sametyakut/EE463-TERM-PROJECT/README.md

# EE463-TERM-PROJECT
This repository is created for DC Motor Drive Project by **Son Motor Bükücüler**.

Team: [Berna ÇORAK](https://github.com/burniebarren), [Musa ULUSOY](https://github.com/Musa1088) and [me](https://github.com/sametyakut).
