sametyakut/EE463-TERM-PROJECT/Reports/FinalReport.docx

EE463 STATIC POWER

CONVERSION-I

TERM PROJECT

FINAL REPORT

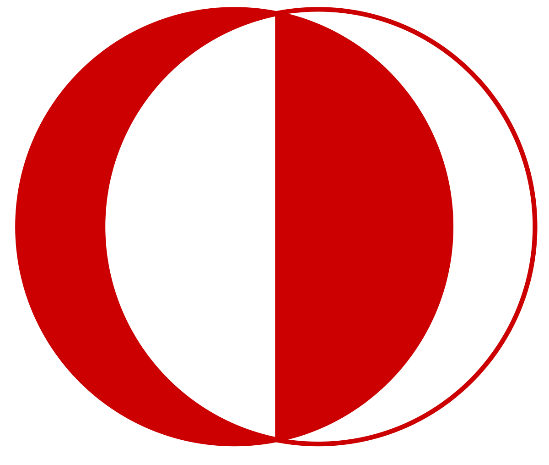
[picture p3: figure]
Orta Doğu Teknik Üniversitesi - Vikipedi

Date: 07.02.2022

Musa Ulusoy 2305555

Muhammet Samet Yakut 2305647

Berna Çorak 2304392

# I. INTRODUCTION

In our term project we were required to build a motor driver circuitry which will run a DC motor via AC grid. In this report, the topology we have chosen and the reason behind it is discussed. Necessary analytical calculations are given. Simulation of the circuitry is talked upon, and component selection is presented. Next, thermal calculations and the implementation are provided. Finally, demonstration results are talked upon, both rated operation and kettle test.

# II. PROJECT DEFINITION

In this project, as mentioned in introduction, we are asked to build a motor driver supplied from the grid -either single or three phase- that can drive an industrial shunt motor with a rated 1500 rpm speed, 220 V and 23.4 A. Field excitation is given by an external DC source. There are several bonus requirements, among which we have chosen Tea Bonus, Analog Controller Bonus and Industrial Design Bonus to implement. For Tea Bonus, the motor that is run with our driver is coupled to a generator which is used to supply voltage to a kettle drawing around 1.5 kW. Our design should be able to withstand until the water is boiled. For Analog Controller Bonus, as the name suggests, the driver needs to be implemented with an analog controller rather than digital. And for Industrial Bonus, the driver should be encased within a box with all ports labeled.

# III. TOPOLOGY SELECTION

For this project, basic topologies that we considered are as follows:

- Center-tap transformer: This topology turned out to be way expensive compared to others (~300 TL), therefore it is automatically eliminated. Besides this, in the small scale it has only one tap at the secondary, decreasing the flexibility of the output voltage, if used as a single component.
- Single phase full bridge diode rectifier with buck converter: This topology is comparably cheaper compared to others. However maximum output voltage that a single-phase diode rectifier can provide is 207 V, when variac is at 100%. That means for a maximum operational output of 180 V, duty cycle (DC) of the buck converter should be around 90%, which is not desired since as DC gets closer to the edges, its output becomes instable and non-reliable.
- Single phase thyristor rectifier: Similarly with the previous topology, maximum output this can provide is 207 V. For 180 V output, 30° of firing angle is required, which is reasonable. However, compared to the next topology especially, two gate driver circuitry is needed, complicating the matters. Even though pricewise being comparable with the three phase full bridge diode rectifier with buck converter, this topology is found to be more error-prone due to this multiple gate driver requirement and hence is not chosen.
- Three phase full bridge diode rectifier with buck converter: This topology is decided upon at the end, due to it being cheap and its ease of implementation. Since the motor acts like a capacitive load in addition with its series parasitic inductance, two components of the buck converter is not necessary, decreasing the cost even further and simplifying the circuitry. Only a gate driver is basically needed, which is doable.
- Three phase thyristor rectifier: Compared with the single phase case, cost and complexity is tripled, thus this topology is, too, eliminated.

# IV. SOLUTION

Figure 1. Schematic model of the selected topology

First of all, the LC filter at the output of the buck converter will not be used because the DC motor has a very large inductance that can filter the current in the square waveform. In other words, the DC machine will be driven with the square wave.

Secondly, transient current must be diminished to obtain a soft start operation. There are two ways: designing a controller (closed-loop operation) or designing a gate driver circuit such that the duty cycle starts from very low values and rises up to the maximum limit manually (open-loop operation). At first, a closed-loop PI controller is tried via TL494 IC; however, it is not ended with success. Therefore, due to lack of time, the open-loop operation is selected, and the following gate-driver circuit is designed.

Finally, the input voltage is desired according to the limited maximum duty cycle, which is 0.65. The duty cycle is limited in order to decrease the conduction loss, and the switching frequency is limited to 1 kHz to reduce the switching loss. So, the required input voltage for obtaining 180 V output voltage is calculated as

## Gate Driver Circuit

As previously mentioned, the open-loop operation with soft start is aimed. The PWM is generated via 555 timer. So, after brief research, the following gate driver circuit is designed, schematic of which is given in Figure 3. The numbers represent the ports of the timer in pin diagram. The pin diagram and appearance of the 555 timer is also presented below in Figure 2.

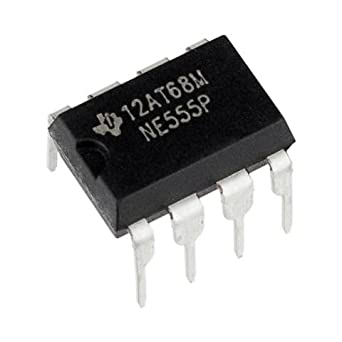
[picture p4: figure]
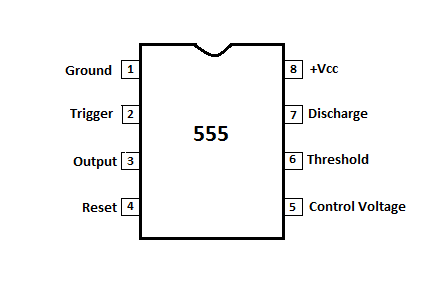
[picture p5: figure]

Figure 2. 555 timer photograph and pin diagram

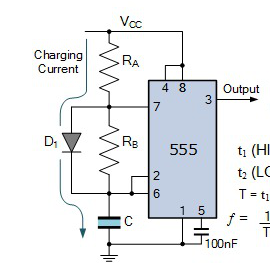
[picture p6: figure]

Figure 3. Gate driver circuitry

According to this topology, the duty cycle can be expressed as . Furthermore, the switching frequency is calculated as . Then, in order to achieve the desired duty cycle and switching frequency, resistor and capacitor parameters are tuned as , , and . RA will be composed of two series potentiometers in order to change the duty cycle. Specifically speaking, RA will be consisting of 100 kΩ and 10 kΩ resistors, which are series. The soft-start operation is achieved via 10 kΩ POT while the 100 kΩ POT is set as zero. After the start, duty cycle is adjusted via 100 kΩ POT.

After the 555 timer, the optocoupler is needed to isolate the gate driver circuit, i.e., prevent the gate driver circuit. For that purpose, the internal schematic of a typical optocoupler is presented to illustrate its working principle.

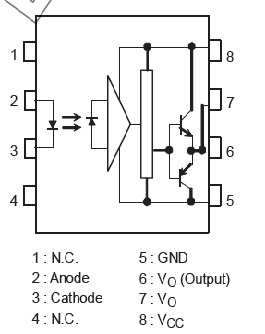
[picture p7: figure]

Figure 4. Schematic of optocoupler

The optocoupler utilizes the light to isolate one side from another, that’s what their name comes from. The picture above is the inside of the optocoupler. So, a 1 kΩ resistor will be placed to the pin 2 in order to limit the LED current in the input side of the optocoupler. Also, the PWM signal generated by the timer circuit is also connected to the second pin. Then, at the 6th or 7th pin, the same PWM signal will also be obtained. The 5th pin will be connected to the switch’s low voltage pin, which is the emitter.

Also, according to the datasheet of the switch (for reasoning of component selection please refer to the preceding simulation results and component selection sections), there must be at least a 10 Ω resistor placed in the gate of the IGBT. However, this value is for nearly perfect applications. Since it is not possible to design such a circuit, a 50 Ω resistor is used to increase the opening time of the switch, i.e., it is used to decrease the switching speed. There is also a 20 kΩ resistor for discharging the junction of the switch when it is turning of. Final version of the gate driver circuit including the IGBT is presented in Figure 5.

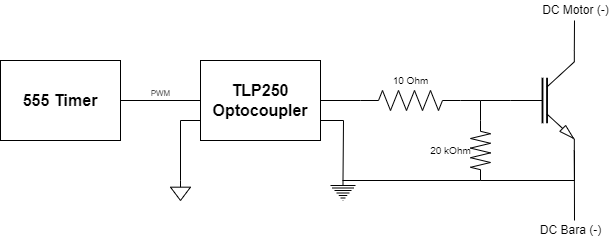
[picture p8: figure]

Figure 5. Schematic of the resultant gate driver

## Buck Converter

Buck converter is a basic step-down converter, and it will be utilized to drop the DC link voltage to the at most 180 V depending on the duty cycle. The basic buck converter topology is presented in Figure 6.

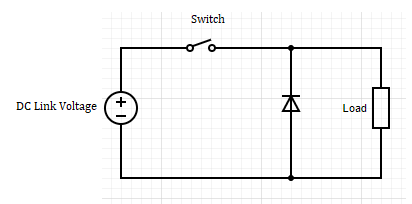
[picture p9: figure]

Figure 6. Schematic model of the basic buck converter

It can be easily seen that whenever switch is on, the output voltage is equal to DC link voltage, and whenever the diode is conducting, output voltage will be zero. Mathematically speaking

If the mean value of the output voltage is calculated, it can be seen that it is equal to 180 V at the maximum duty cycle which is the desired output voltage according to the project definition. In more detail,

In the preceding section, this solution procedure will be implemented in Simulink environment except the gate driver circuit because the components in gate driver circuit are not available in Simulink. So, gate driver topology will be implemented and simulated in LTSpice environment.

# V. SIMULATION RESULTS

The desired topology is simulated via Simulink environment. The Simulink model can be seen in Figure 7. According to the model, steady state switch current and voltage, diode current and voltage, and output voltage and current are given in Figures 8-10.

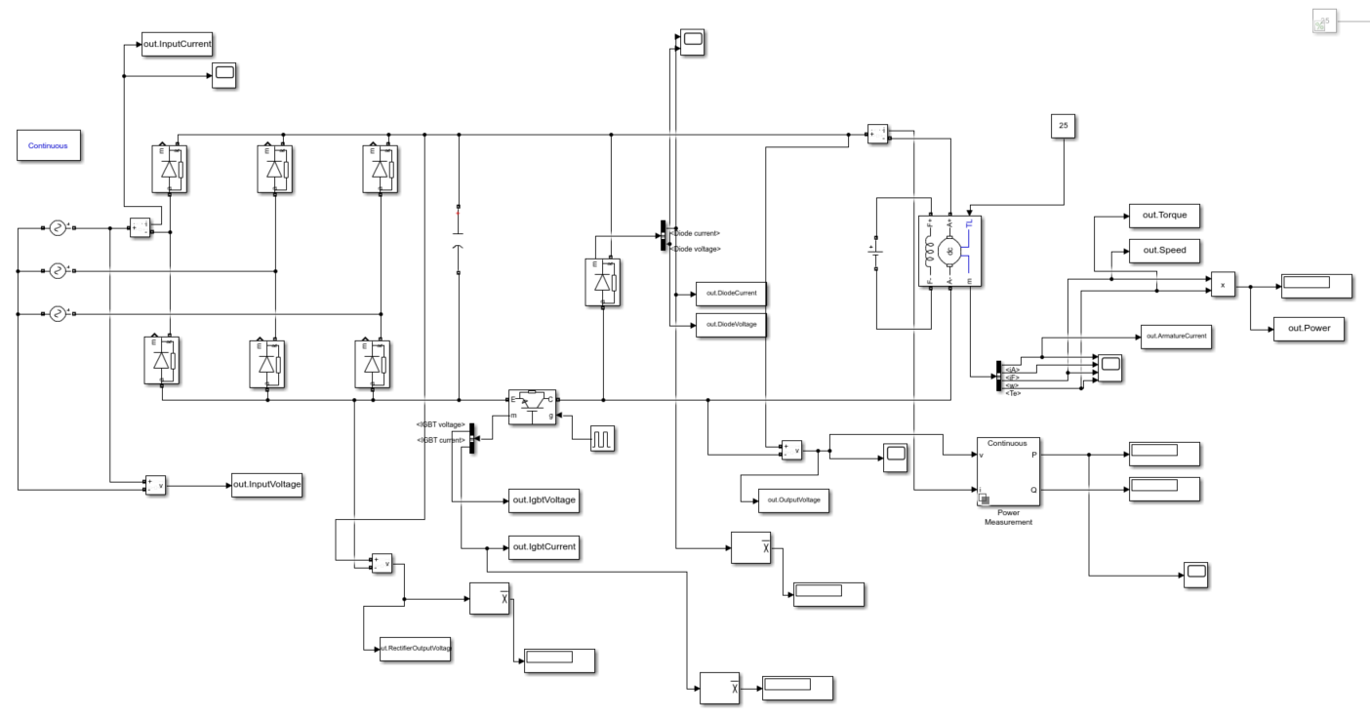
[picture p10: figure]

Figure 7. Simulink model

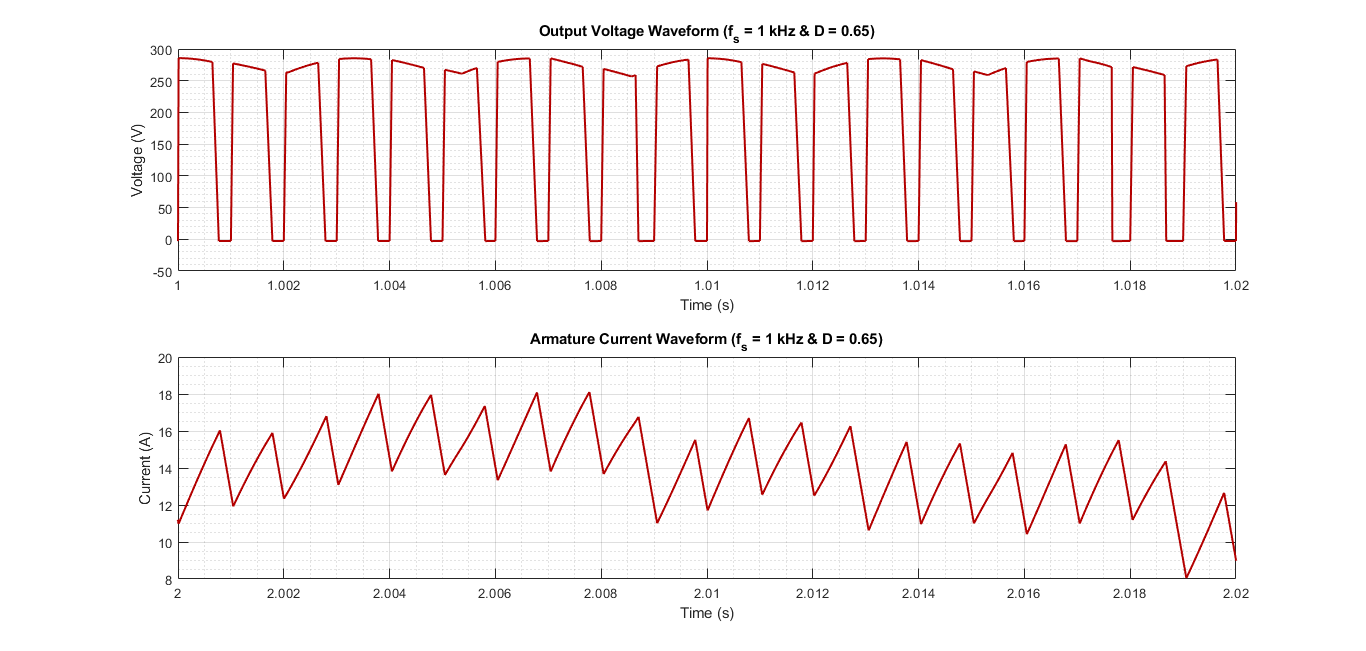
[picture p11: figure]

Figure 8. Output voltage and armature current waveforms

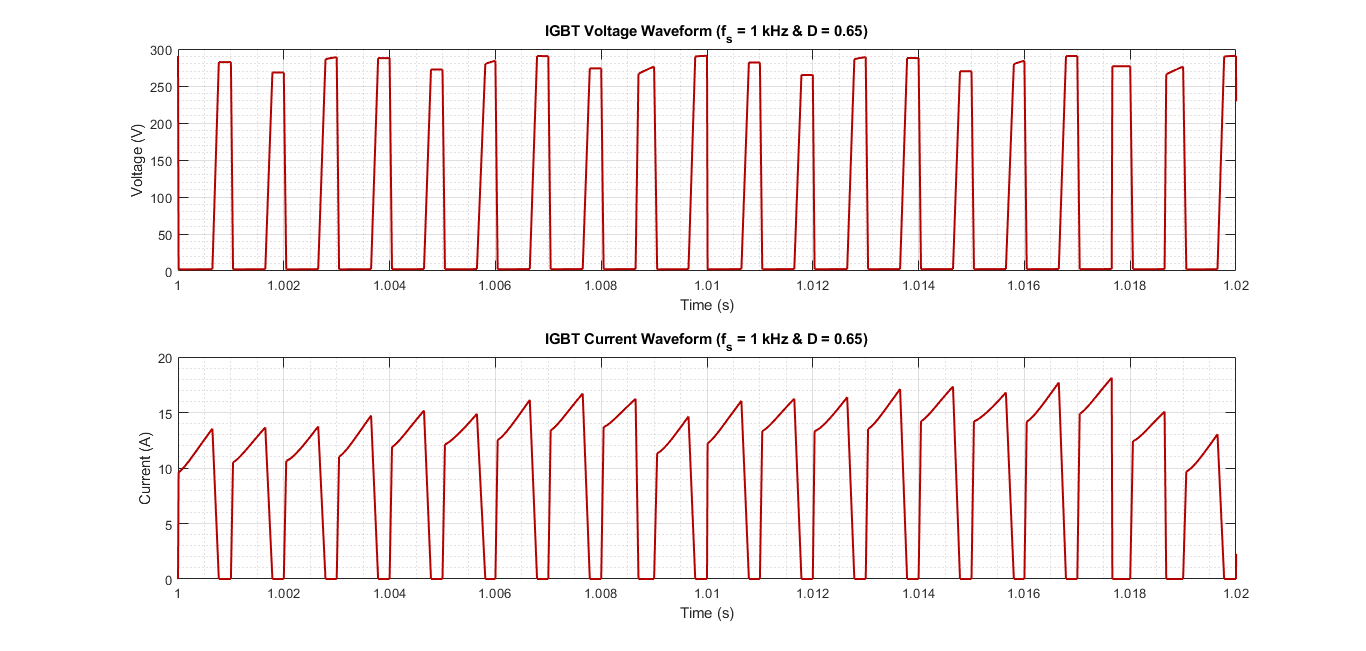
[picture p12: figure]

Figure 9. IGBT voltage and current waveforms

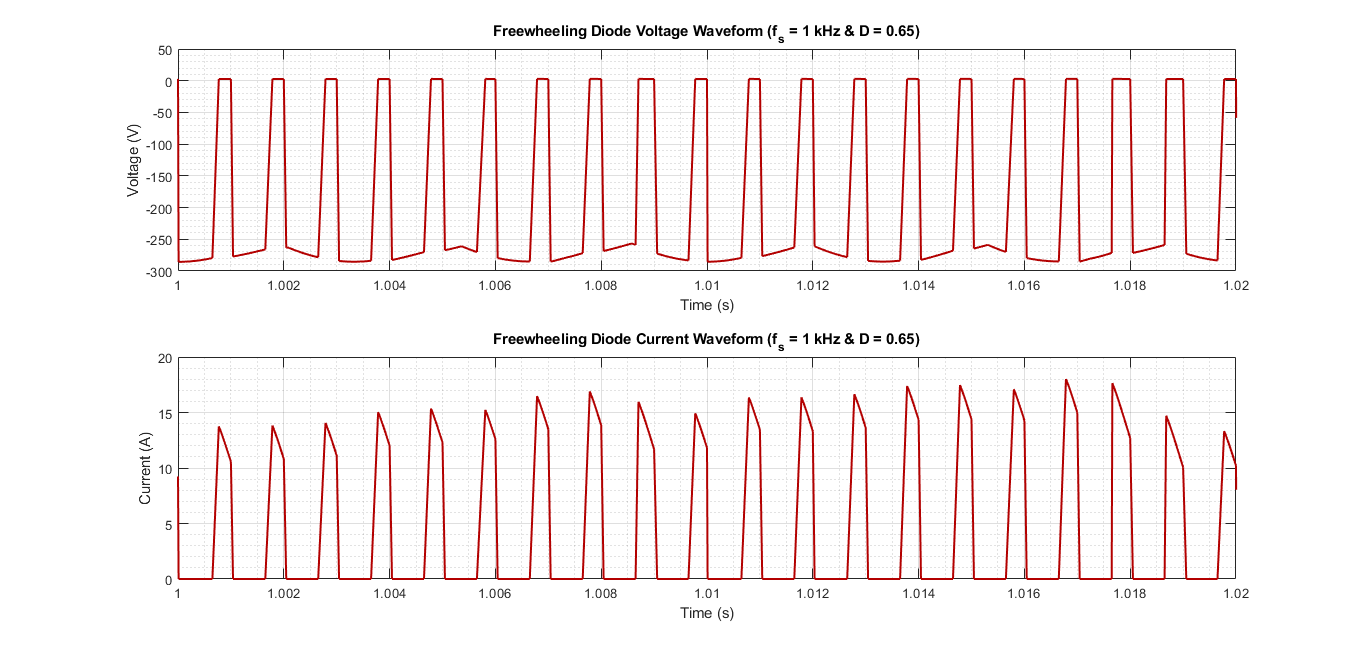
[picture p13: figure]

Figure 10. Freewheeling diode voltage and current waveforms

However, during transient, current flows through the circuit is extremely high that has capability of damaging the components, which can also be seen from the Figures 11-13.

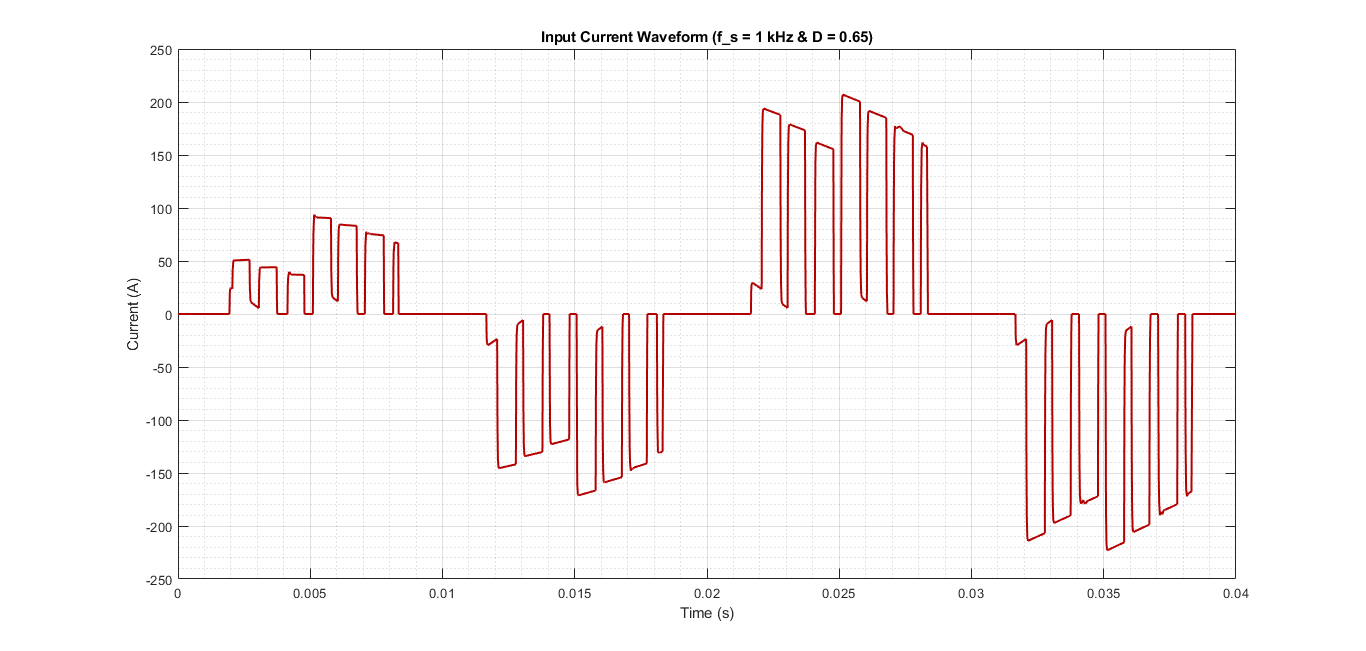
[picture p14: figure]

Figure 11. Input current waveform

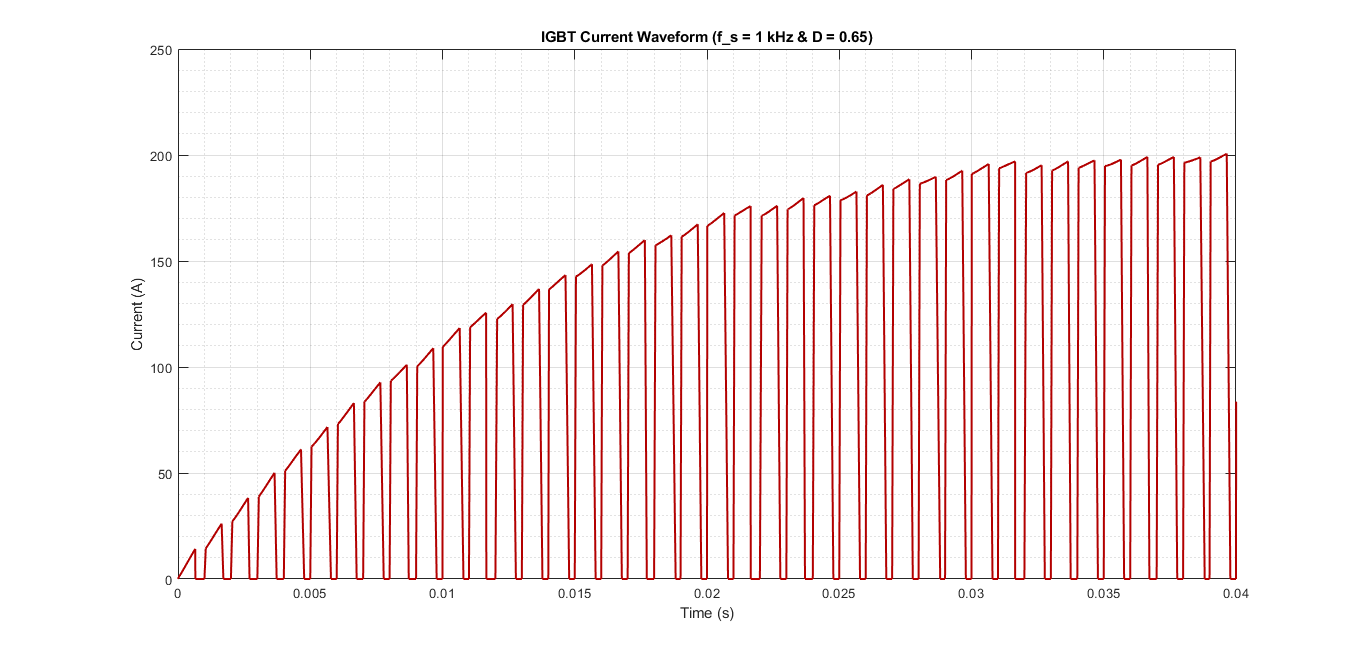
[picture p15: figure]

Figure 12. IGBT current waveform

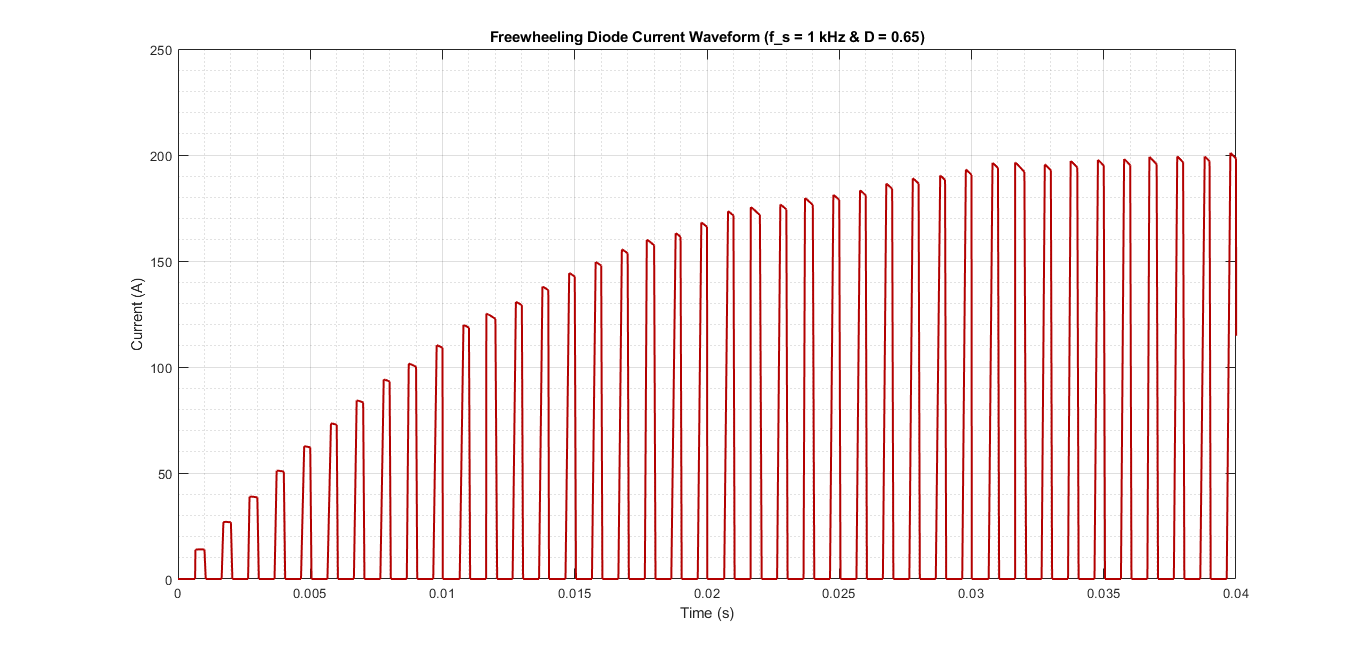
[picture p16: figure]

Figure 13. Freewheeling diode current waveform

The inrush current in transient part will be eliminated with the help of the gate designed gate driver circuit.

The simulation result of the gate driver circuit is presented in Figure 14, excluding the optocoupler because it has no effect on the output of the gate driver circuit.

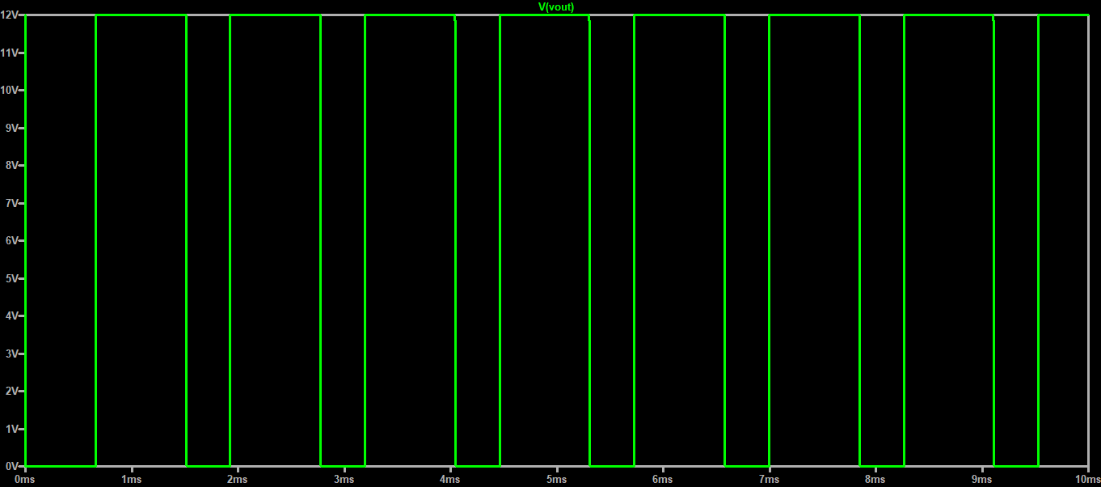
[picture p17: figure]

Figure 14. Output waveform

# VI. COMPONENT SELECTION

According to the simulation results and calculations, the components are decided as follows.

- As a rectifier, a 50 Hz three-phase rectifier module is chosen. The specific model of this rectifier is IXYS VUO36-16NO8. It is bought from a local electronic store in Ankara.
- The DC link capacitor must withstand at least 276.75 V. Also, in the simulation model, various capacitor values are tried and according to price and performance, two 330 μF 400 V electrolytic capacitors are chosen. It is bought from “direnc.net”. Its specific model and datasheet are not available on the seller’s site.
- At first, the switch is thought of as MOSFET whereas due to global chip shortage, MOSFETs with higher voltage ratings were too expensive, even are not in stock. So, IGBT present in the laboratory is chosen since it meets the requirements, which are withstanding around 300 V and must carry a 10 A in average, and gives a safety margin. The specific model of the IGBT is IXGH24N60C4D1.
- Freewheeling diode is chosen as MUR3060PT because it satisfies the values obtained from the simulation, which should carry around 10 A in average, and it is available in a local electronic store in Ankara.
- TLP250 optocoupler is chosen since it is available in the laboratory.

Datasheets of all the components can be seen in GitHub Repository. (https://github.com/sametyakut/EE463-TERM-PROJECT)

# VII. THERMAL CALCULATIONS

It is known that thermal calculation is necessary for providing suitable conditions for the temperature vulnerable circuit components. Otherwise, generally, because of the overheating components can be defected or can be harmed. The main reason of the heat increase in a circuit is power losses. These power losses occur as heat in the components so, doing power loss calculations before the thermal calculations is necessary.

## Power Losses:

Semiconductors can be heated to the high temperatures due to the losses inside of them. If the temperature exceeds the limit, semiconductor device can be broken. Hence, it must be considered the losses in the semiconductor devices:

- Switching losses
- Conduction losses

-Switching Loss formula (Reverse Recovery Loss):

P_(rr) =V_(reverse) *I

P_(rr) =V_(reverse) *f_(sw) *Q_(rr)

P_(rr) =V_(reverse) *f_(sw) *t_(rr) *I_(rr) *1/2

-Conduction Loss Formula

P_(cond) =V_(forward) *I_(diode)

### Three-phase rectifier module VUO36-16NO8:

From the simulation report, it was indicated that switching loss for this component was unsignificant. So, let’s check for the conduction loss:

V_(Forward) =1.04 V @ 25°C, @ I_f =15 A

I_f =10.32 A (Maximum average current that passes through a diode in our design)

P_(cond) =1.04 V*10.32 A=10.73 W=P_(total)

Figure 15. Thermal resistance of the three-phase rectifier module

Figure 16. Temperature specifications of the three-phase rectifier module

Let’s assume Tambient = 40˚C. Then, calculate the temperature of the rectifier module.

T_(junction) =T_(ambient) +R_(thJC) *P_(total) =115.11˚C

Actually, this temperature is in the range of the device’s operation temperature. However, we were also decided to implement a heatsink to this device too. We planned to implement HBT254 to the rectifier.

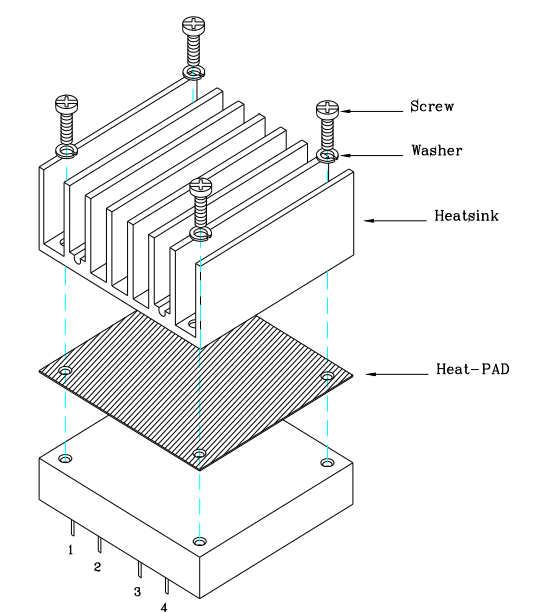
[picture p18: figure]

Figure 17. Possible implementation of the heatsink to the rectifier module

This heatsink has thermal resistance as RHA = 3 ( ˚C/W) . Hence, by using this heatsink,

T_(junction) =T_(ambient) +(R_(thJH) +R_(HA) )*P_(total) =82.9˚C

### Freewheeling Diode DSEP30-06B:

Beside of the three-phase rectifier module, for the freewheeling diode, it was indicated that switching loss for this component was unsignificant in the simulation report. So, let’s check for the conduction loss:

V_(Forward) =2.51 V @ 150°C, @ I_f =15 A

I_f =10.32 A*(1-D)=5.16 A for D=0.5 (Current that passes through this diode in our design)

P_(cond) =1.2V*5.16A=6.19 W

Figure 18. Thermal resistance of the diode

Figure 19. Operating temperature of the diode

Again, assume Tambient = 40˚C. Now, calculate the temperature of the diode.

T_(junction) =T_(ambient) +R_(thJA) *P_(total) =287.6˚C

As it can be observed, temperature of the diode exceeds the operating temperature range. Hence, heatsink and fan usage is necessary. For the heatsink, we have decided to use HBT254.

This heatsink has thermal resistance as RHA = 3 ( ˚C/W) . On the other hand, it will be used a 12V DC San Ace 80 fan.

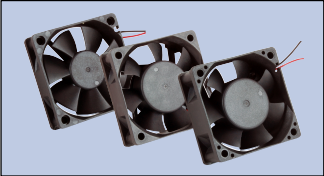
[picture p19: figure]

Figure 20. Possible fan selection

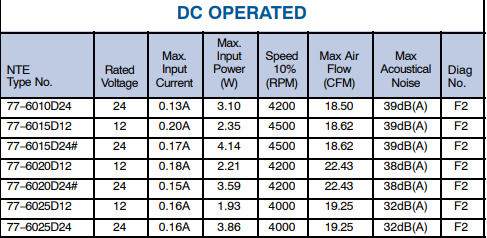
[picture p20: figure]

Figure 21. DC fan specifications

It was planned to use 77−6020D12 and it has CFM = 22.43, which equal to LFM = 578.83. Besides, heatsink’s thermal resistance is 0.95 ( ˚C/W) under 400 LFM. Hence, by using this heatsink and fan,

T_(junction) =T_(ambient) +(R_(thJC) +R_(HA) )*P_(total) =55.2˚C

### IGBT IXGH24N60C4D1:

The IGBT used as a switch in the buck converter is IXGH24N60C4D1. For this IGBT, let’s do the loss calculations:

E_(on) =0.40 mJ @25°C, @V_(GE) =15V, @V_(CE) =360 V,@R_G =10Ω (Switch on energy of the IGBT)

E_(off) =0.30 mJ @25°C, @V_(GE) =15V, @V_(CE) =360 V,@R_G =10Ω (Switch off energy of the IGBT)

P_(switching) =f*(E_(on) +E_(off) )=3.5W

V_(CE) _(sat) =1.95 @V_(GE) =15V, @125°C (Collector-Emitter voltage in saturation)

I_(CE) =10.32A*D=5.16 A for D=0.5 (Current passes through this IGBT when it is conducting)

P_(conduction) =V_(CE_(sat)) *I_(CE) =20.12 W

Hence,
P_(total) =23.62 W

Figure 21. Temperature specifications of the IGBT

Figure 22. Thermal resistance of the IGBT

We have decided to use the same fan and same heatsink that we planned to use for the diode. Hence, same calculations are valid for the IGBT.

Assume Tambient = 40˚C.
T_(junction) =T_(ambient) +(R_(thJC) +R_(thCS) +R_(HA) )*P_(total) =82.75˚C

So, for the worst case, IGBT can stand and work properly.

# VIII. DEMO RESULTS

In the demo day, procedure was like the following:

1. Make all the necessary connections.
2. Set the field excitation to 150 V.
3. Set the variac to a level that motor can receive rated voltage (~50%).
4. Give the dc input to start the switching.
5. Manipulate the POTs to change the speed of the motor to 1300 rpm rated.

Initially, these procedures were done, and the results are noted, given in Figures 23-28.

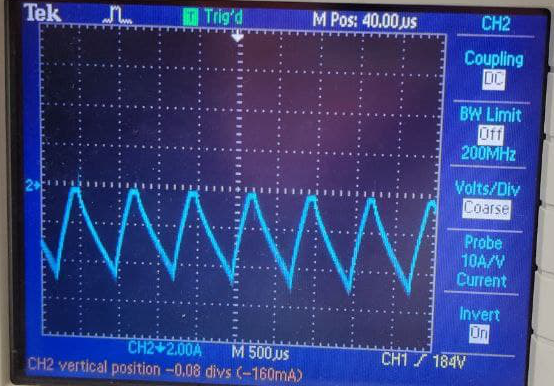
[picture p21: figure]
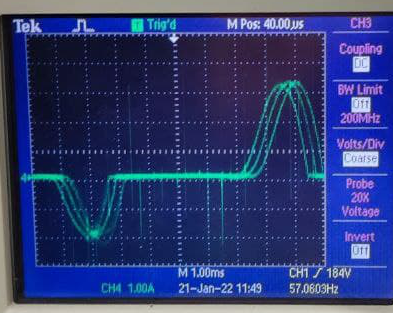
[picture p22: figure]

Figure 23. Input current Figure 24. Output current

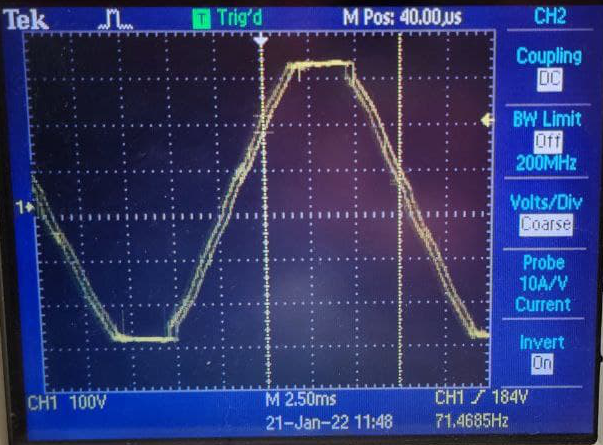
[picture p23: figure]
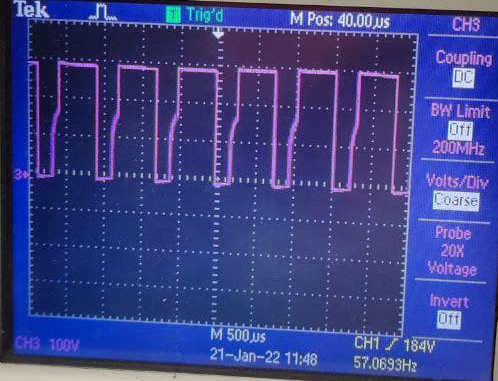
[picture p24: figure]

Figure 25. Input voltage Figure 26. Output voltage

First peculiar thing noticed was the clipping of the input voltage waveform, as seen in Figure 25, which was assumed and used to be sinusoidal. After brief research, it is found to be either a result of the core saturation of the transformer within variac, or a natural output of capacitor voltage transformer (CVT), which uses an initial capacitive voltage divider, that may cause this behaviour. From the photos we have taken, we could not see the model of the variac, therefore could not further elaborate on which is the cause. But it is not something affecting the operation of the driver; therefore, it is not examined further.

Figure 23 is better analyzed if one imagines it as inverted with respected to x axis, our probe connection was the other way around. Current has a ripple of around 4 A, just touching DCM boundary. Approximating the waveform as triangular, its rms is around 4/(√3)=2.3 A , which can be verified by the power meter measurement seen in Figure 27, in Channel 4.

DCM behaviour can be verified in Figure 26 as well, where a mid-step in the voltage waveform is seen. A duty cycle of around 66% can be seen with a dc output voltage of
300*66% ~= 100 V.

In Figure 24, a spike in the output current waveform can be seen. It corresponds to the duration where the input voltage is clipped. Input voltage is taken as single phase, however the rectifier is three phase. Therefore during that range line-to-line voltage is also deviating from sinusoidal, leading to these spikes in the output current.

In Figure 27, power meter results can be seen. From top to down, input voltage rms, input power in kW, output power in kW and input current rms is given. Approximately, 60 W is lost on the driver, which is in agreement with our thermal calculations.

In Figure 28, thermal camera image of our driver is given. As can be seen, the fan and heatsink solutions proved themselves and max temperature is max. 33.1 °C.

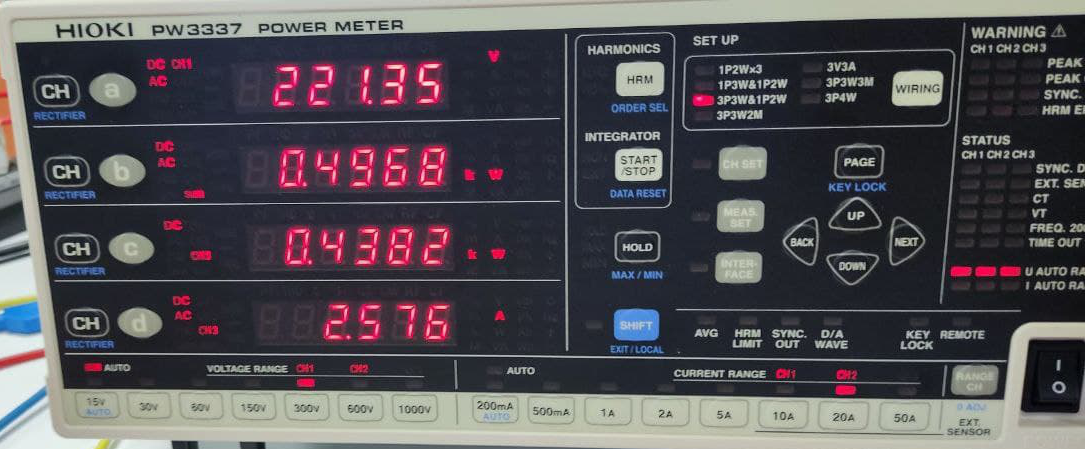
[picture p25: figure]

Figure 27. Power meter results

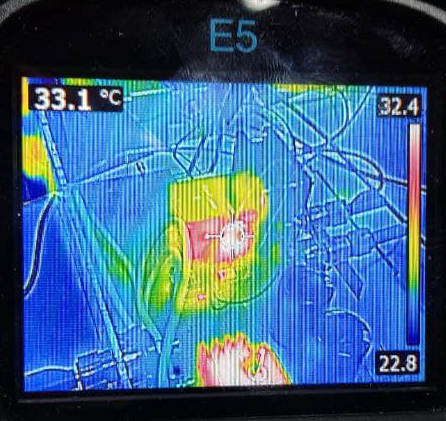
[picture p26: figure]

Figure 28. Temperature of the IGBT

Since we planned to get the tea bonus, a test with the kettle had to be done too. Kettle test was done with the following procedure:

1. Motor is stopped by arranging the duty cycle to 0%.
2. Kettle is connected.
3. Duty cycle is increased by arranging the POTs.
4. After obtaining 1.8kW at the output, duty cycle is fixed.
5. Wait till the water boils.

After this procedure was done, results are noted too.

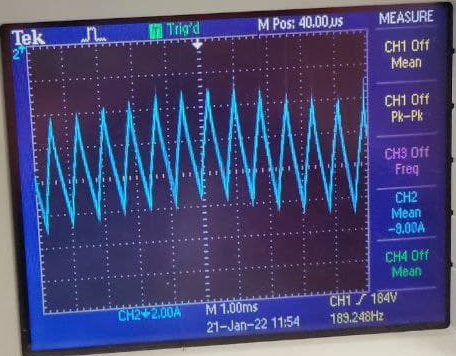
[picture p27: figure]
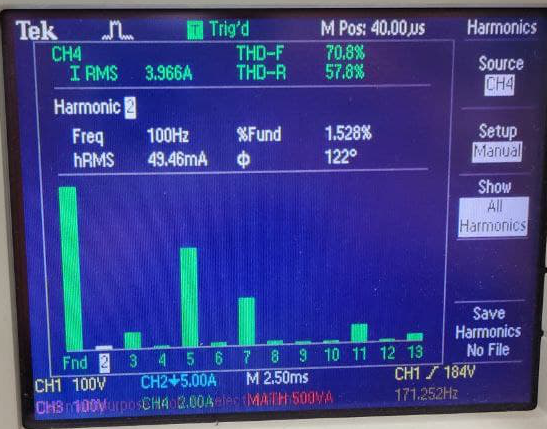
[picture p28: figure]

Figure 29. Input current of the kettle test Figure 30. Output current THD of the kettle test

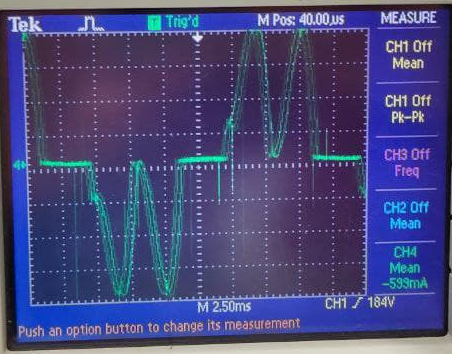
[picture p29: figure]
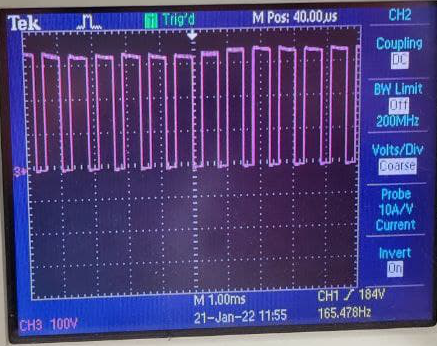
[picture p30: figure]

Figure 31. Output current of the kettle test Figure 32. Output voltage of the kettle test

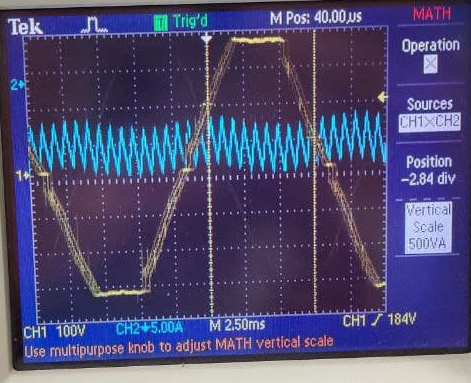
[picture p31: figure]
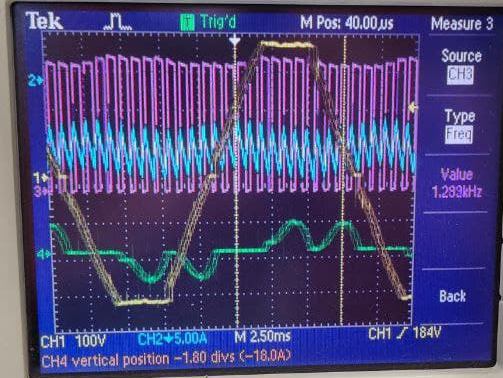
[picture p32: figure]

Figure 33. Input voltage and current of the kettle test Figure 34. All the signals in the same graph

in the same graph

From the Figures 29-34, resultant graphs can be seen. Since the kettle is connected to the circuit, it draws more current. Hence, input current graph in the Figure 29 is far from the DCM boundary.

Also, in the Figure 31, one can see the spikes again. The reason of the spikes was explained in the previous setup. One can check the corresponding THD graph of the output current. On the other hand, in the Figure 35, rms current of the generator can be seen.

From the Figure 32, it can be seen that there is no mid-step in the output voltage since it was far from the DCM boundary. Hence, resultant graph is less distorted.

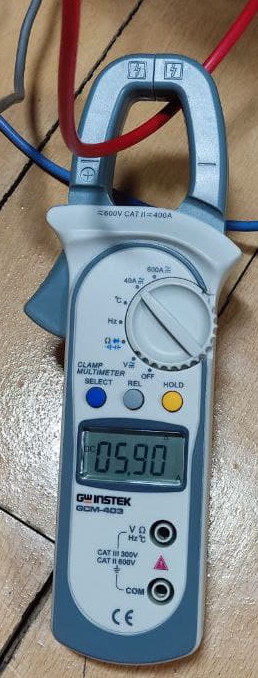
[picture p33: figure]
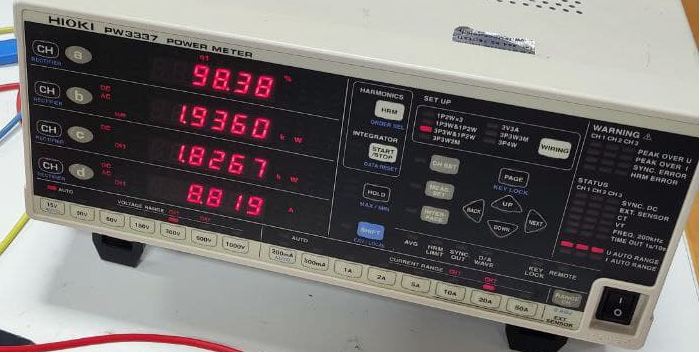
[picture p34: figure]

Figure 35. Current of the generator Figure 36. Power meter results for the kettle test

In Figure 36, power meter results can be seen. From top to down, efficiency, input power in kW, output power in kW and input current rms is given. Approximately, 110 W is lost on the driver, which dissipated as heat in the driver.

In the Figure 37, thermal camera result can be seen. Since the losses are higher than the previous case, IGBT and diode is hotter, but in the proper operating temperature range.

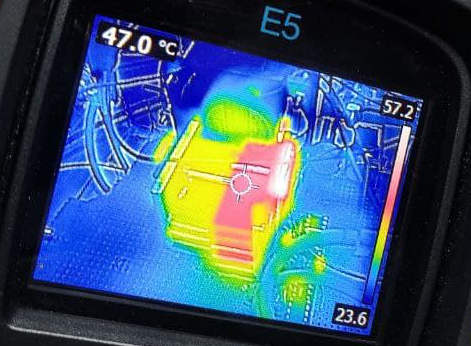
[picture p35: figure]

Figure 37. Temperture of the IGBT for the kettle test

# IX. CONCLUSION

In this report, generally, it was explained how the motor driver is implemented. We have given information about how the topology and components were chosen. Simulation results corresponding to this topology and components are indicated and discussed. Thermal calculations of the components were done and thermal requirements were shown. It was explained how the implementation was done. Lastly, demo results for the rated operation and kettle test were given.

# X. REFERENCES

[1] VUO36-16NO8 ixys: Mouser. Mouser Electronics. (n.d.). Retrieved January 2, 2022, from https://www.mouser.com/ProductDetail/IXYS/VUO36-16NO8?qs=t7yjd2JO%2FgTYiRCZukE39A%3D%3D

[2] DSEP30-06B ixys: Mouser. Mouser Electronics. (n.d.). Retrieved January 2, 2022, from https://www.mouser.com/ProductDetail/IXYS/DSEP30-06B?qs=t7yjd2JO%2FgSuf4%2FHQWiQoQ%3D%3D

[3] Alldatasheet.com. (n.d.). IXGH24N60C4D1 datasheet(pdf) - ixys corporation. ALLDATASHEET.COM - Datasheet search site for Electronic Components and Semiconductors and other semiconductors. Retrieved January 2, 2022, from https://www.alldatasheet.com/datasheet-pdf/pdf/415136/IXYS/IXGH24N60C4D1.html
