sametyakut/EE463-TERM-PROJECT/Reports/FinalReportMusa.docx

# THERMAL CALCULATIONS

It is known that thermal calculation is necessary for providing suitable conditions for the temperature vulnerable circuit components. Otherwise, generally, because of the overheating components can be defected or can be harmed. The main reason of the heat increase in a circuit is power losses. These power losses occur as heat in the components so, doing power loss calculations before the thermal calculations is necessary.

## Power Losses:

Semiconductors can be heated to the high temperatures due to the losses inside of them. If the temperature exceeds the limit, semiconductor device can be broken. Hence, it must be considered the losses in the semiconductor devices:

- Switching losses
- Conduction losses

-Switching Loss formula (Reverse Recovery Loss):

P_(rr) =V_(reverse) *I

P_(rr) =V_(reverse) *f_(sw) *Q_(rr)

P_(rr) =V_(reverse) *f_(sw) *t_(rr) *I_(rr) *1/2

-Conduction Loss Formula

P_(cond) =V_(forward) *I_(diode)

### Three-phase rectifier module VUO36-16NO8:

From the simulation report, it was indicated that switching loss for this component was unsignificant. So, let’s check for the conduction loss:

V_(Forward) =1.04 V @ 25°C, @ I_f =15 A

I_f =10.32 A (Maximum average current that passes through a diode in our design)

P_(cond) =1.04 V*10.32 A=10.73 W=P_(total)

Figure 1:Thermal resistance of the three-phase rectifier module

Figure 2:Temperature specifications of the three-phase rectifier module

Let’s assume Tambient = 40˚C. Then, calculate the temperature of the rectifier module.

T_(junction) =T_(ambient) +R_(thJC) *P_(total) =115.11˚C

Actually, this temperature is in the range of the device’s operation temperature. However, we were also decided to implement a heatsink to this device too. We planned to implement HBT254 to the rectifier.


Figure 3:Possible implementation of the heatsink to the rectifier module

This heatsink has thermal resistance as RHA = 3 ( ˚C/W) . Hence, by using this heatsink,

T_(junction) =T_(ambient) +(R_(thJH) +R_(HA) )*P_(total) =82.9˚C

### Freewheeling Diode DSEP30-06B:

Beside of the three-phase rectifier module, for the freewheeling diode, it was indicated that switching loss for this component was unsignificant in the simulation report. So, let’s check for the conduction loss:

V_(Forward) =2.51 V @ 150°C, @ I_f =15 A

I_f =10.32 A*(1-D)=5.16 A for D=0.5 (Current that passes through this diode in our design)

P_(cond) =1.2V*5.16A=6.19 W

Figure 4:Thermal resistance of the diode

Figure 5:Operating temperature of the diode

Again, assume Tambient = 40˚C. Now, calculate the temperature of the diode.

T_(junction) =T_(ambient) +R_(thJA) *P_(total) =287.6˚C

As it can be observed, temperature of the diode exceeds the operating temperature range. Hence, heatsink and fan usage is necessary. For the heatsink, we have decided to use HBT254.

This heatsink has thermal resistance as RHA = 3 ( ˚C/W) . On the other hand, it will be used a 12V DC San Ace 80 fan.


Figure 6:Possible fan selection


Figure 7:DC fan specifications

It was planned to use 77−6020D12 and it has CFM = 22.43, which equal to LFM = 578.83. Besides, heatsink’s thermal resistance is 0.95 ( ˚C/W) under 400 LFM. Hence, by using this heatsink and fan,

T_(junction) =T_(ambient) +(R_(thJC) +R_(HA) )*P_(total) =55.2˚C

### IGBT IXGH24N60C4D1:

The IGBT used as a switch in the buck converter is IXGH24N60C4D1. For this IGBT, let’s do the loss calculations:

E_(on) =0.40 mJ @25°C, @V_(GE) =15V, @V_(CE) =360 V,@R_G =10Ω (Switch on energy of the IGBT)

E_(off) =0.30 mJ @25°C, @V_(GE) =15V, @V_(CE) =360 V,@R_G =10Ω (Switch off energy of the IGBT)

P_(switching) =f*(E_(on) +E_(off) )=3.5W

V_(CE) _(sat) =1.95 @V_(GE) =15V, @125°C (Collector-Emitter voltage in saturation)

I_(CE) =10.32A*D=5.16 A for D=0.5 (Current passes through this IGBT when it is conducting)

P_(conduction) =V_(CE_(sat)) *I_(CE) =20.12 W

Hence,

P_(total) =23.62 W

Figure 8:Temperature specifications of the IGBT

Figure 9:Thermal resistance of the IGBT

We have decided to use the same fan and same heatsink that we planned to use for the diode. Hence, same calculations are valid for the IGBT.

Assume Tambient = 40˚C.
T_(junction) =T_(ambient) +(R_(thJC) +R_(thCS) +R_(HA) )*P_(total) =82.75˚C

So, for the worst case, IGBT can stand and work properly.

# DEMO RESULTS

In the demo day, procedure was like the following:

1. Make all the necessary connections
2. Set the variac to a level that motor can receive rated voltage.
3. Give the dc input to start the switching.
4. Manipulate the POTs to change the speed of the motor.

Initially, these procedures were done, and the results are noted.

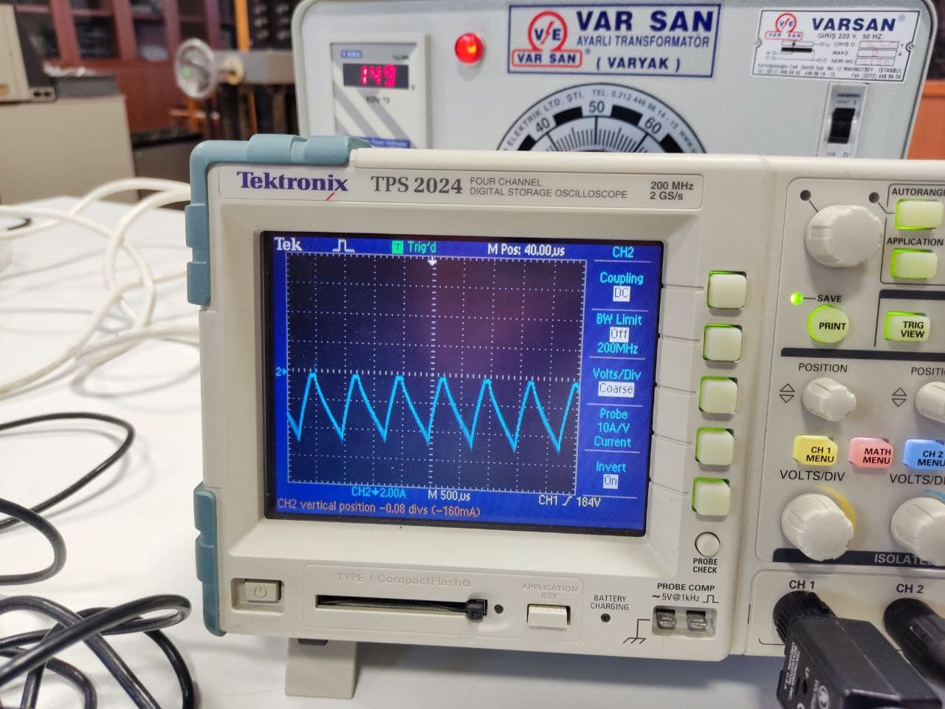
[picture p36: figure]

Figure 10:Input current

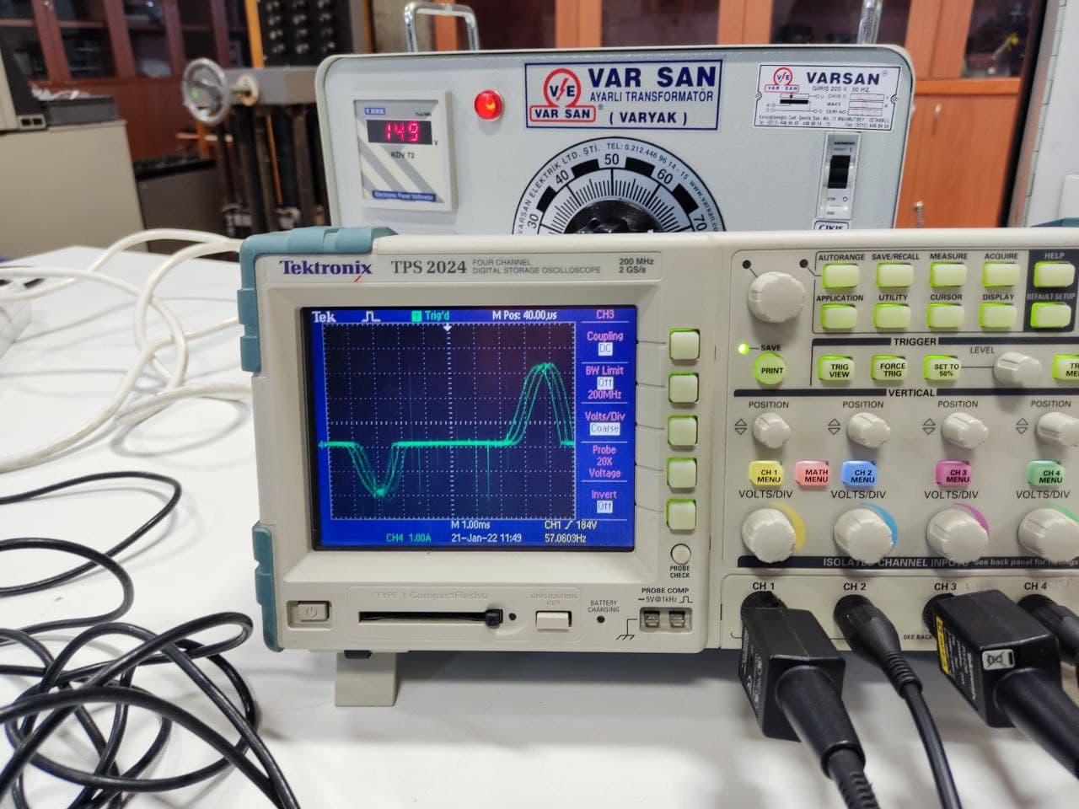
[picture p37: figure]

Figure 11:Output current

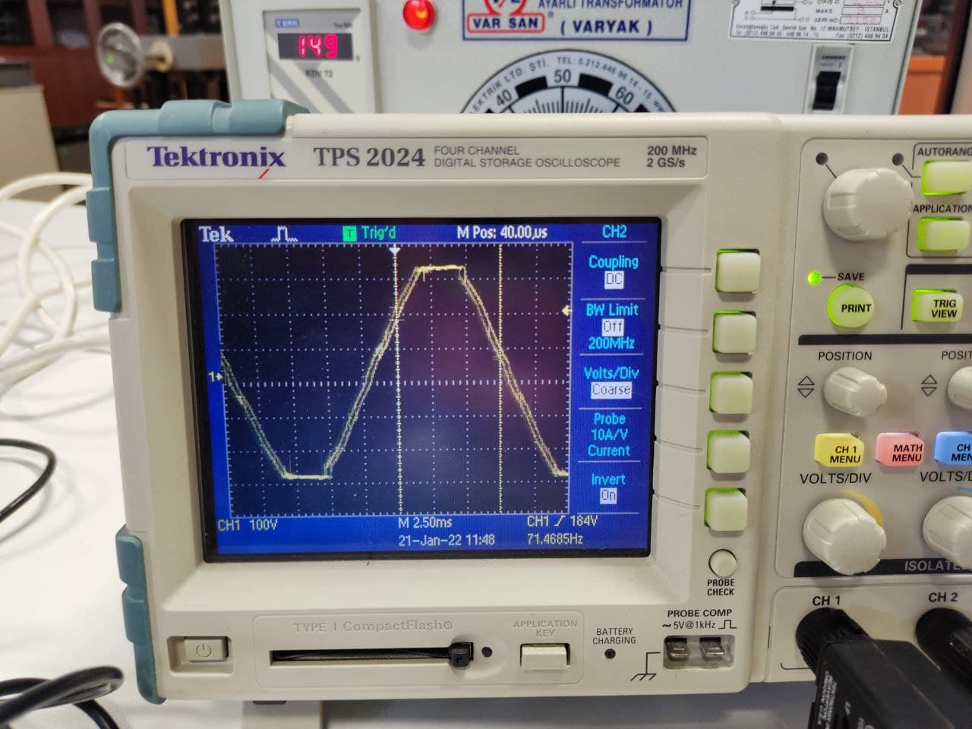
[picture p38: figure]

Figure 12:Input voltage

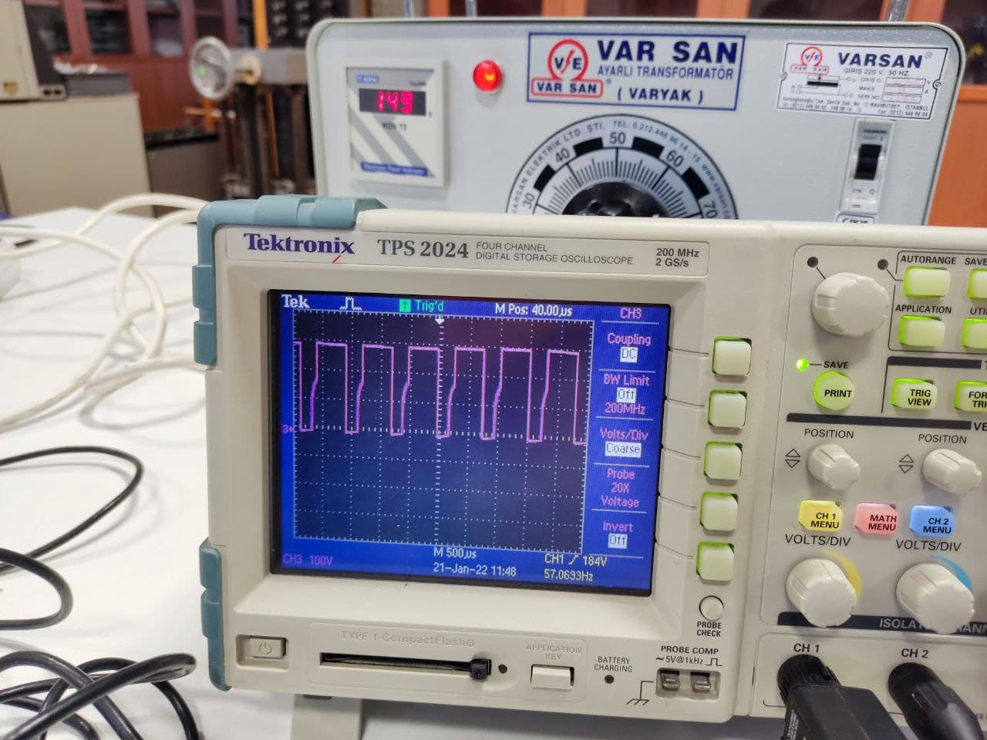
[picture p39: figure]

Figure 13:Output voltage

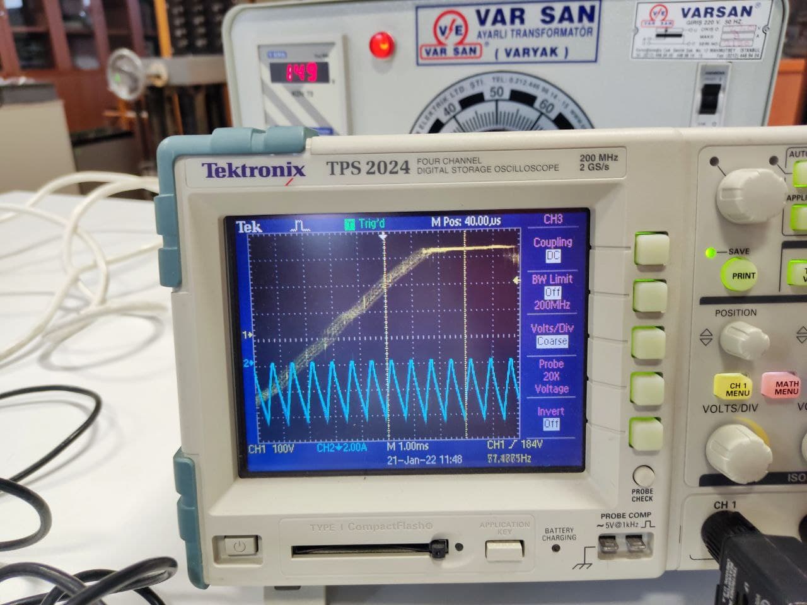
[picture p40: figure]

Figure 14:Input voltage and input current in the same graph

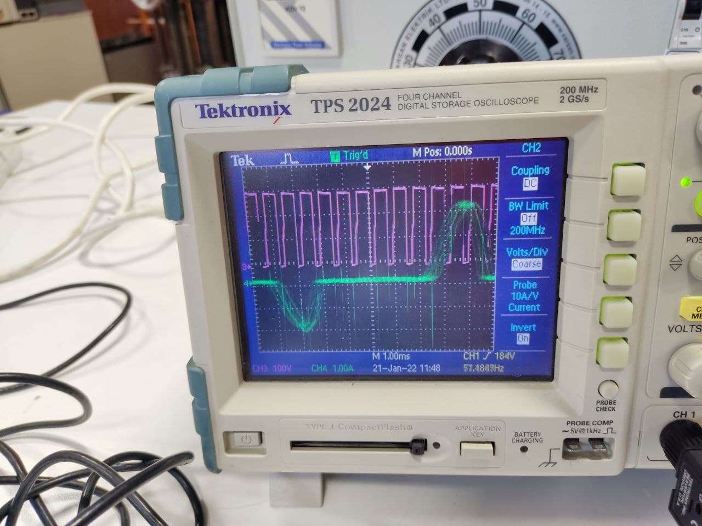
[picture p41: figure]

Figure 15:Output voltage and output current in the same graph

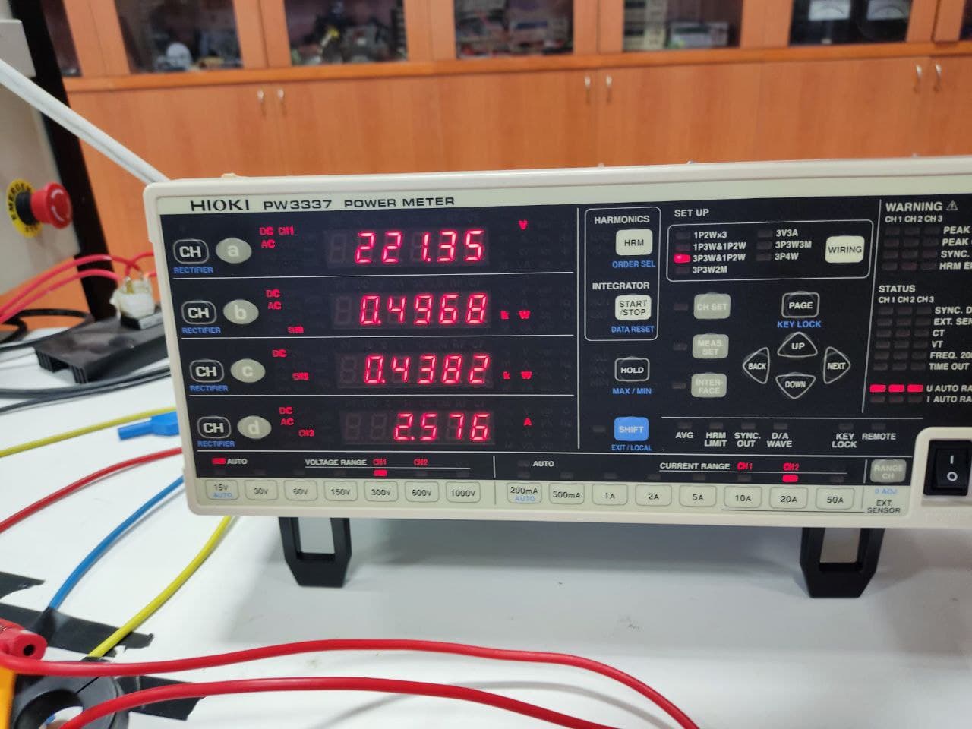
[picture p42: figure]

Figure 16:Power meter results

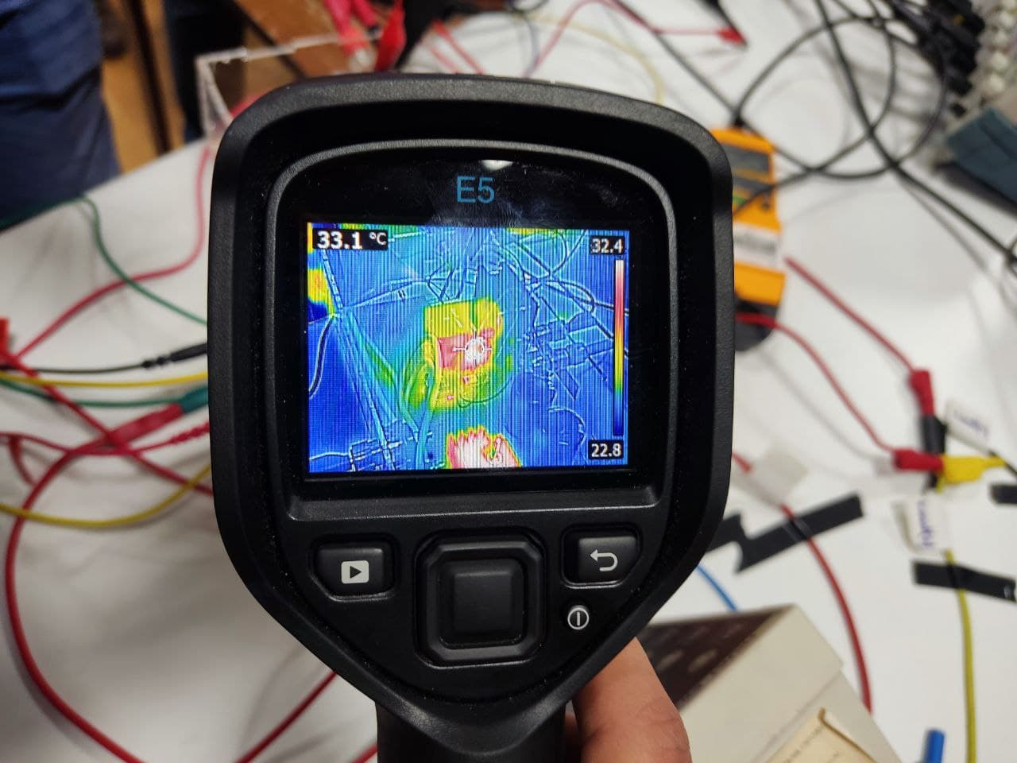
[picture p43: figure]

Figure 17:Temperature of the IGBT

Since we planned to get the tea bonus, a test with the kettle had to be done too. Kettle test was done with the following procedure:

1. Motor is stopped by arranging the duty cycle to 0%
2. Kettle is connected
3. Duty cycle is increased by arranging the POTs
4. After obtaining 1.8kW at the output, duty cycle is fixed
5. Wait till the water boils.

After this procedure was done, results are noted too.

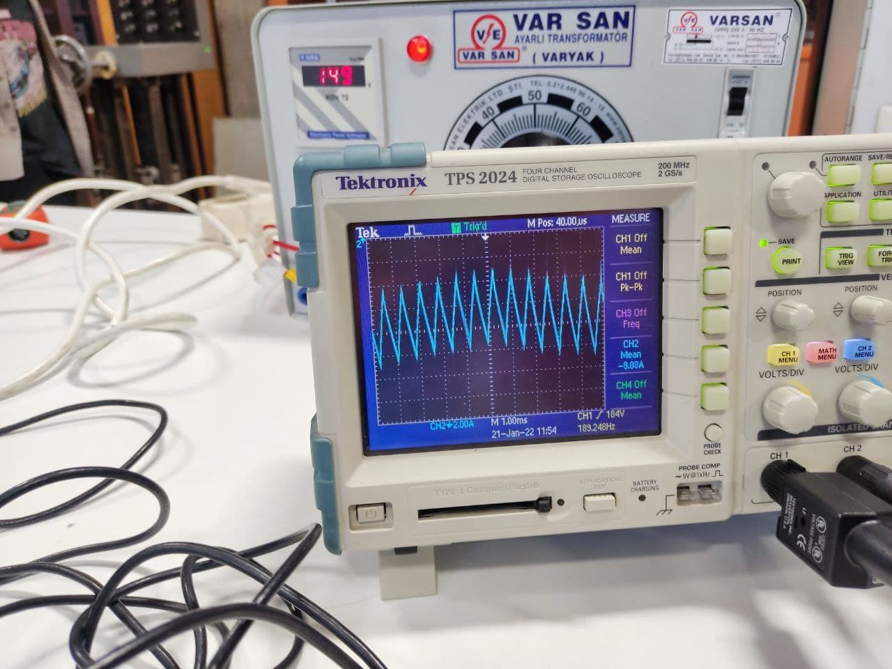
[picture p44: figure]

Figure 18:Input current of the kettle test

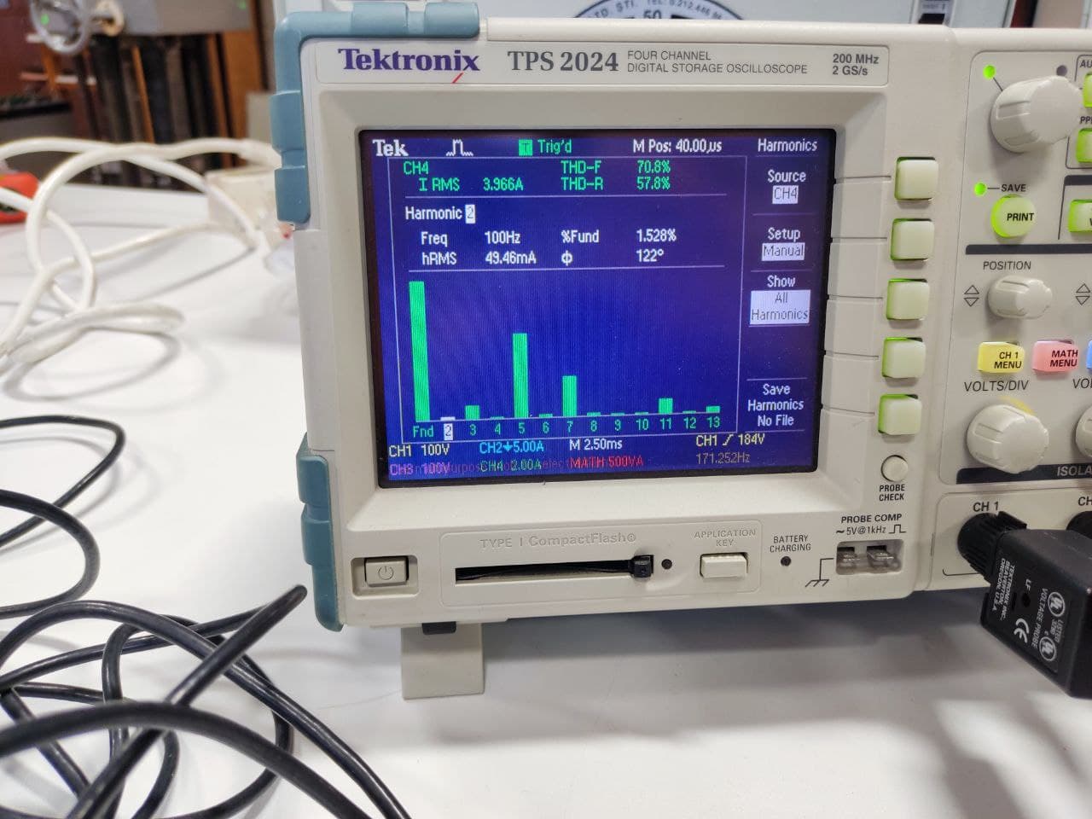
[picture p45: figure]

Figure 19:Output current THD of the kettle test

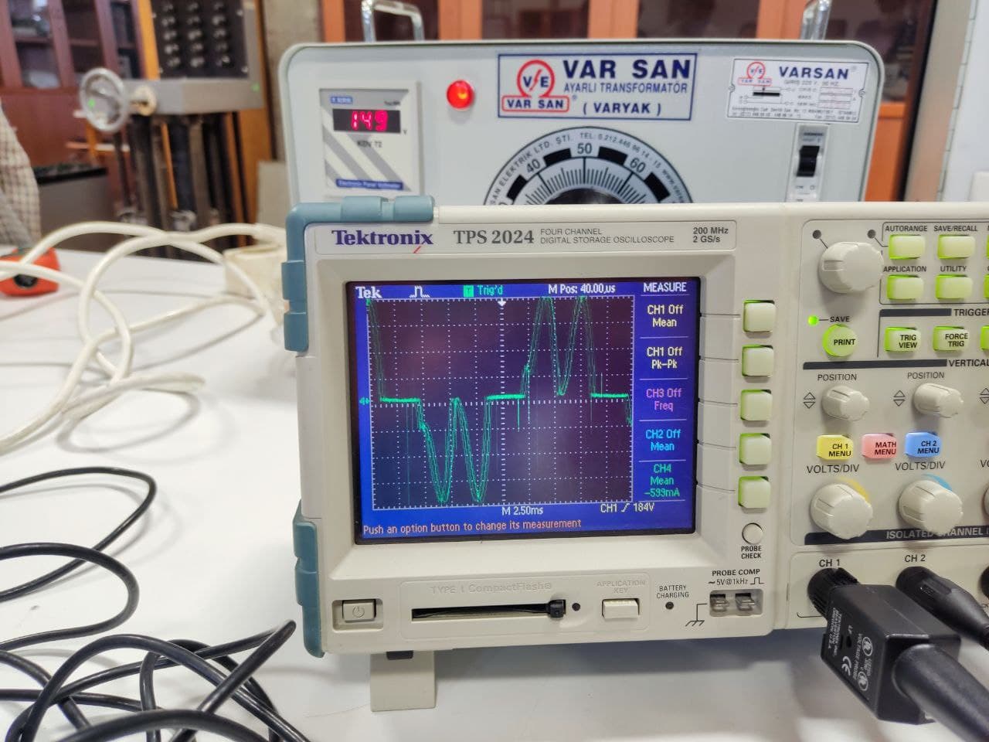
[picture p46: figure]

Figure 20:Output current of the kettle test

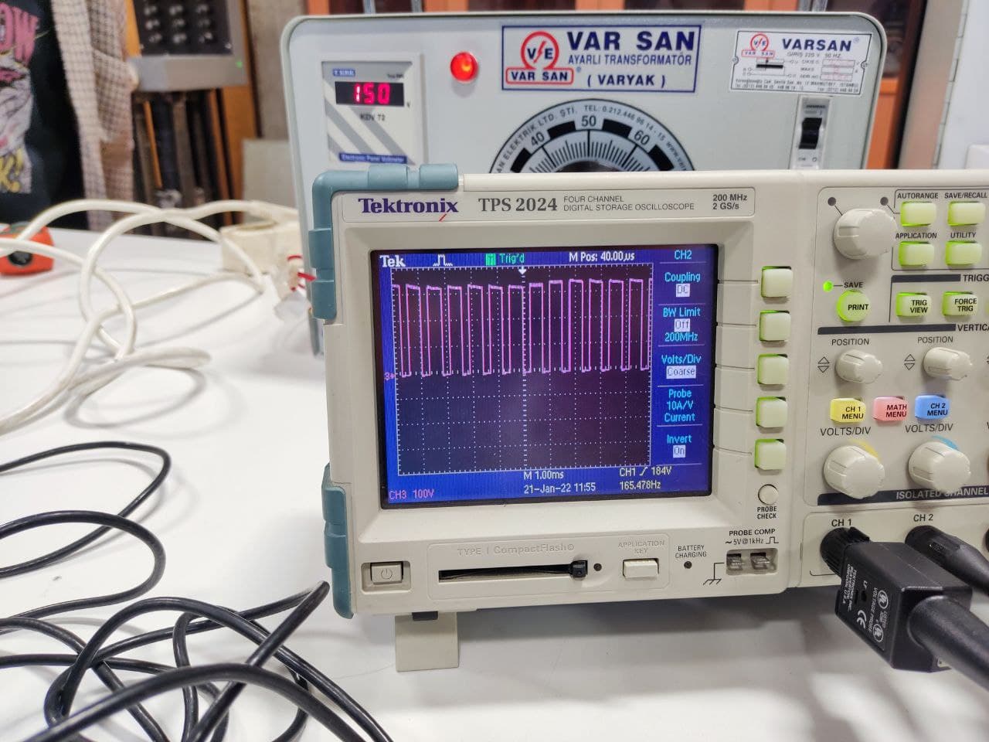
[picture p47: figure]

Figure 21:Output voltage of the kettle test

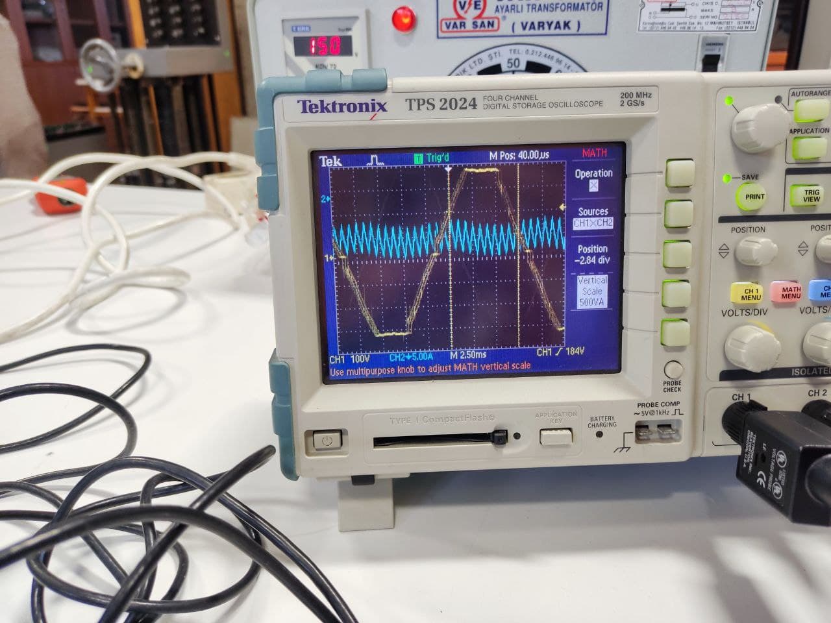
[picture p48: figure]

Figure 22:Input voltage and current of the kettle test in the same graph

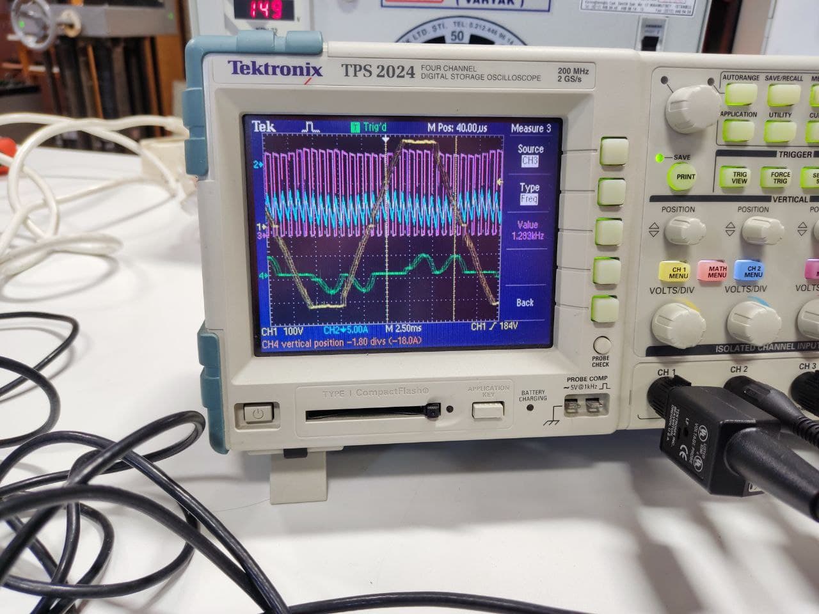
[picture p49: figure]

Figure 23:All the signals in the same graph

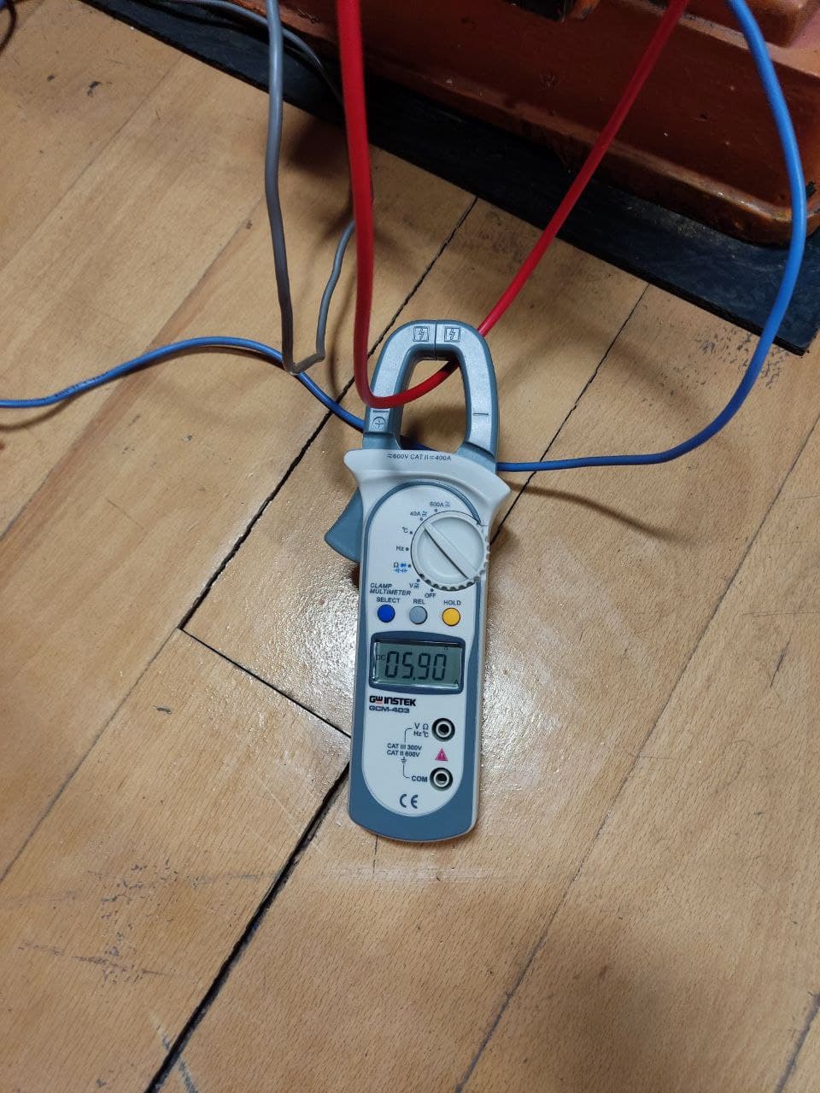
[picture p50: figure]

Figure 24:Current of the generator

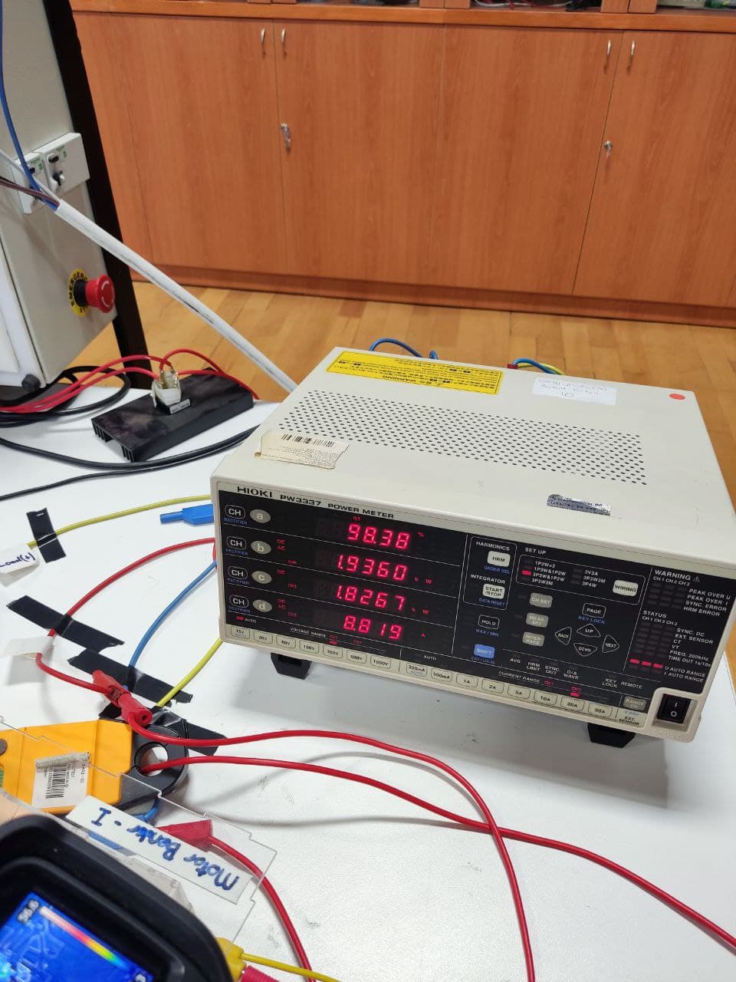
[picture p51: figure]

Figure 25:Power meter results for the kettle test

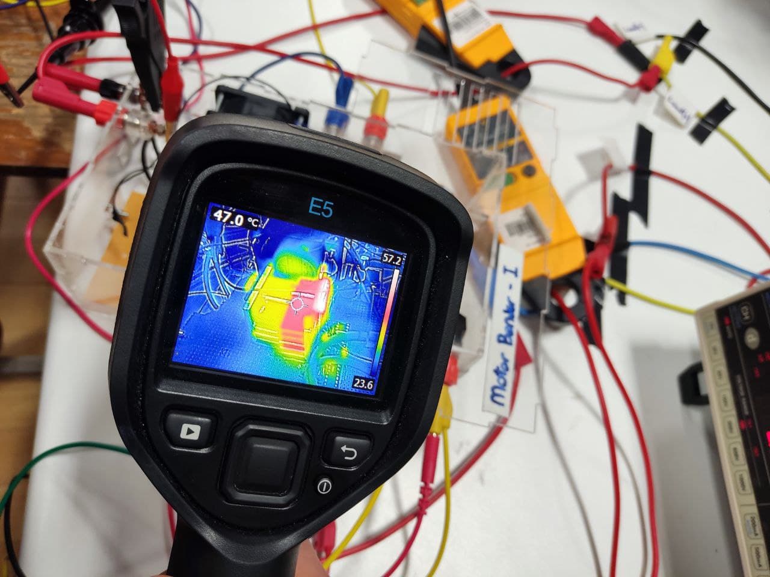
[picture p52: figure]

Figure 26:Temperture of the IGBT for the kettle test
