sametyakut/EE463-TERM-PROJECT/Presentations/FeedbackSession.pptx

## Son Motor Bükücüler

Musa Ulusoy 2305555
Muhammet Samet Yakut 2305647
Berna Corak 2304392

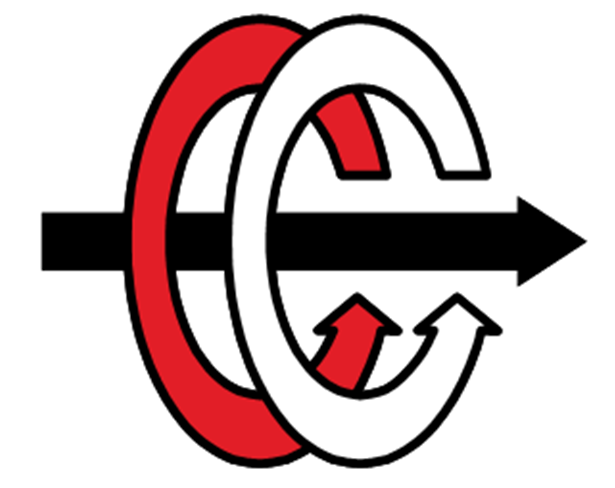
[picture p53: figure]
Formlar ve Görseller | ODTÜ ELEKTRİK - ELEKTRONİK MÜHENDİSLİĞİ
Orta Doğu Teknik Üniversitesi - Vikipedi

## Overview

- Topology Selection
- Simulations
- Thermal Calculations

## Topology Selection

- Centre-tap transformer
- Single phase full bridge diode rectifier with buck converter
- Single phase thyristor rectifier
- Three phase full bridge diode rectifier with buck converter
- Three phase thyristor rectifier

## Topology Selection

- ~~Centre~~~~-tap~~ ~~transformer~~
-expensive & not practical
- ~~Single~~ ~~phase~~ ~~full~~ ~~bridge~~ ~~diode~~ ~~rectifier~~ ~~with~~ ~~buck~~ ~~converter~~
-DC of 90% is needed for max. output
- ~~Single~~ ~~phase~~ ~~thyristor~~ ~~rectifier~~
-two gate driver ~more error-prone
- Three phase full bridge diode rectifier with buck converter
-cheaper & single gate driver
- ~~Three~~ ~~phase~~ ~~thyristor~~ ~~rectifier~~
-expensive & complex

## Simulations

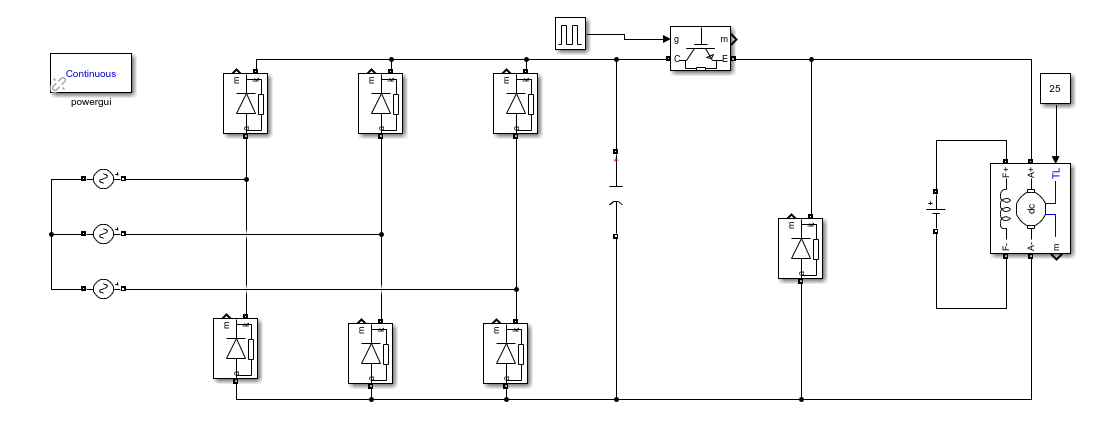
[picture p54: figure]

## Simulations

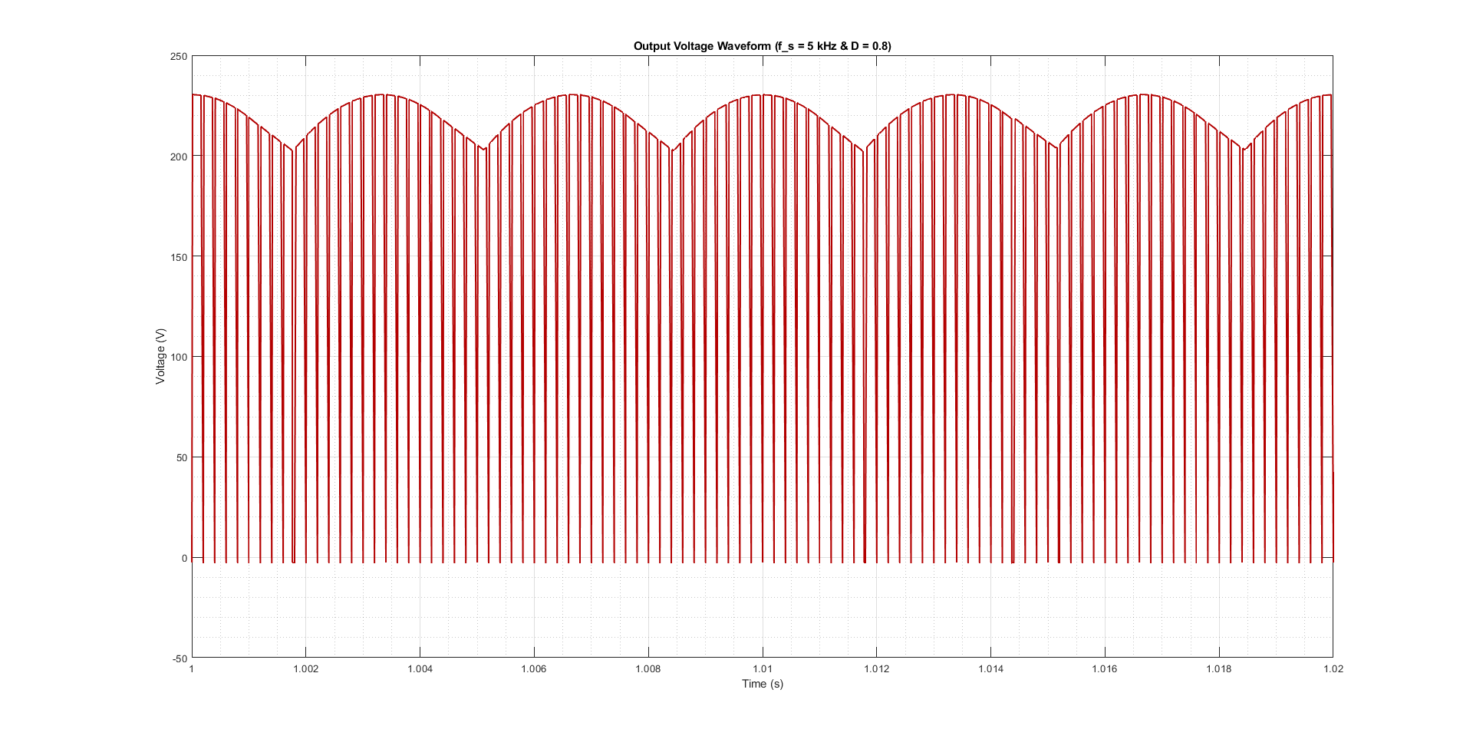
[picture p55: figure]
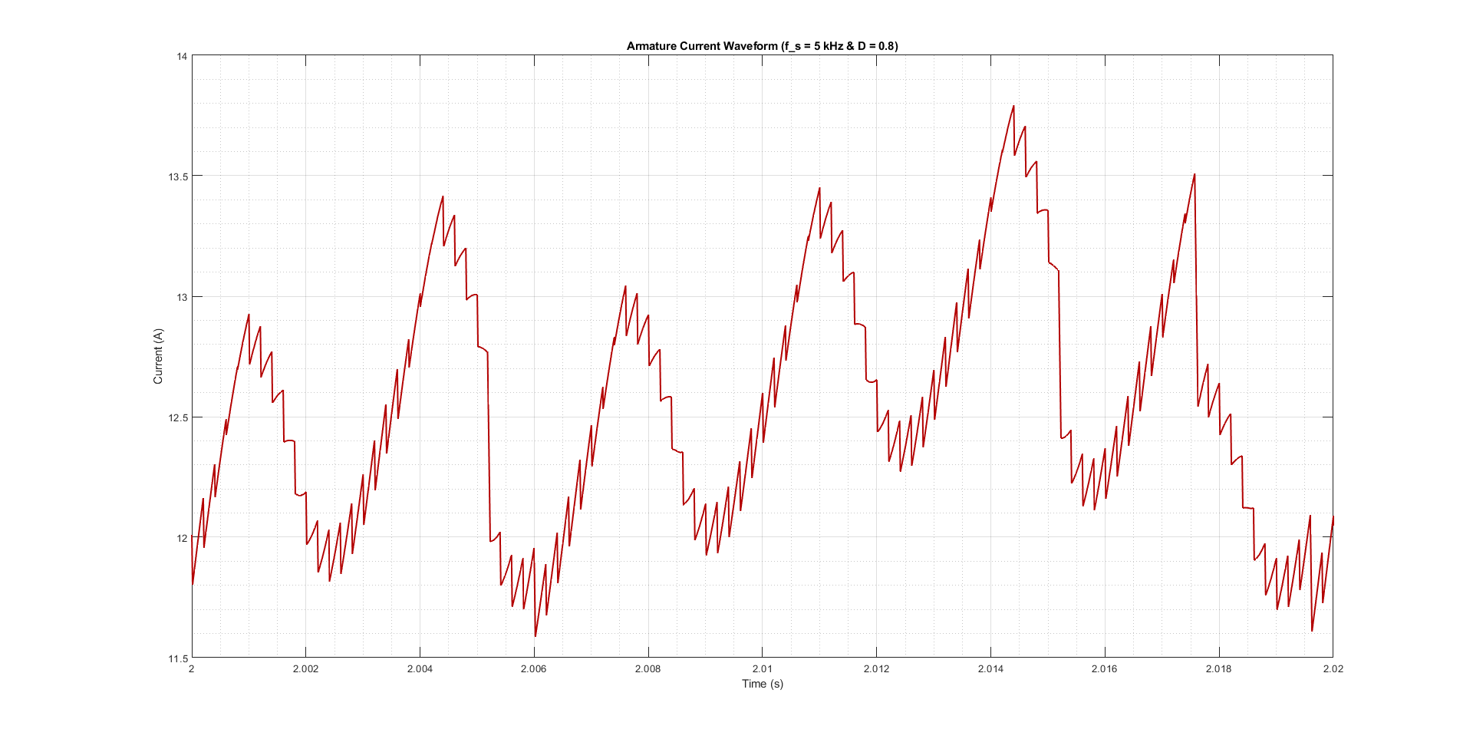
[picture p56: figure]

## Simulations

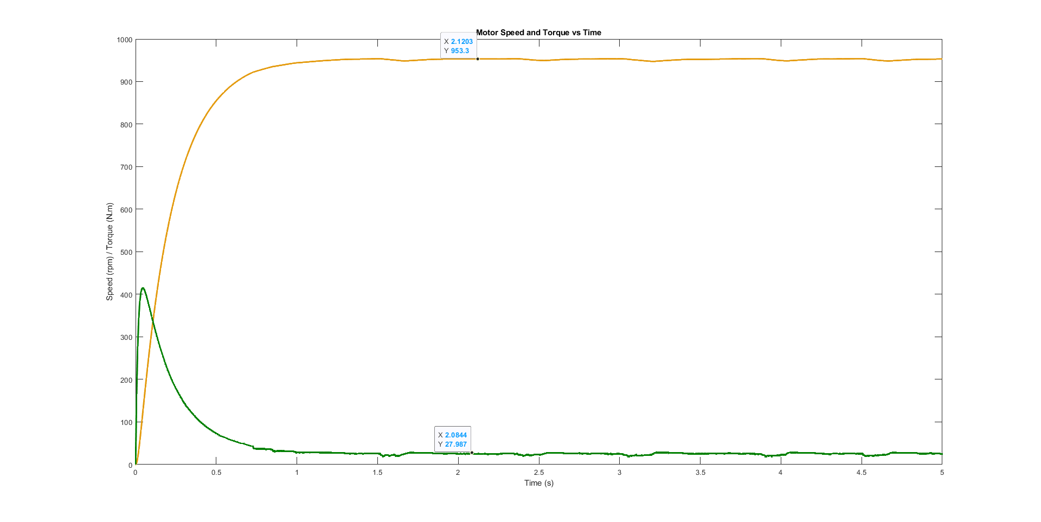
[picture p57: figure]

## Simulations

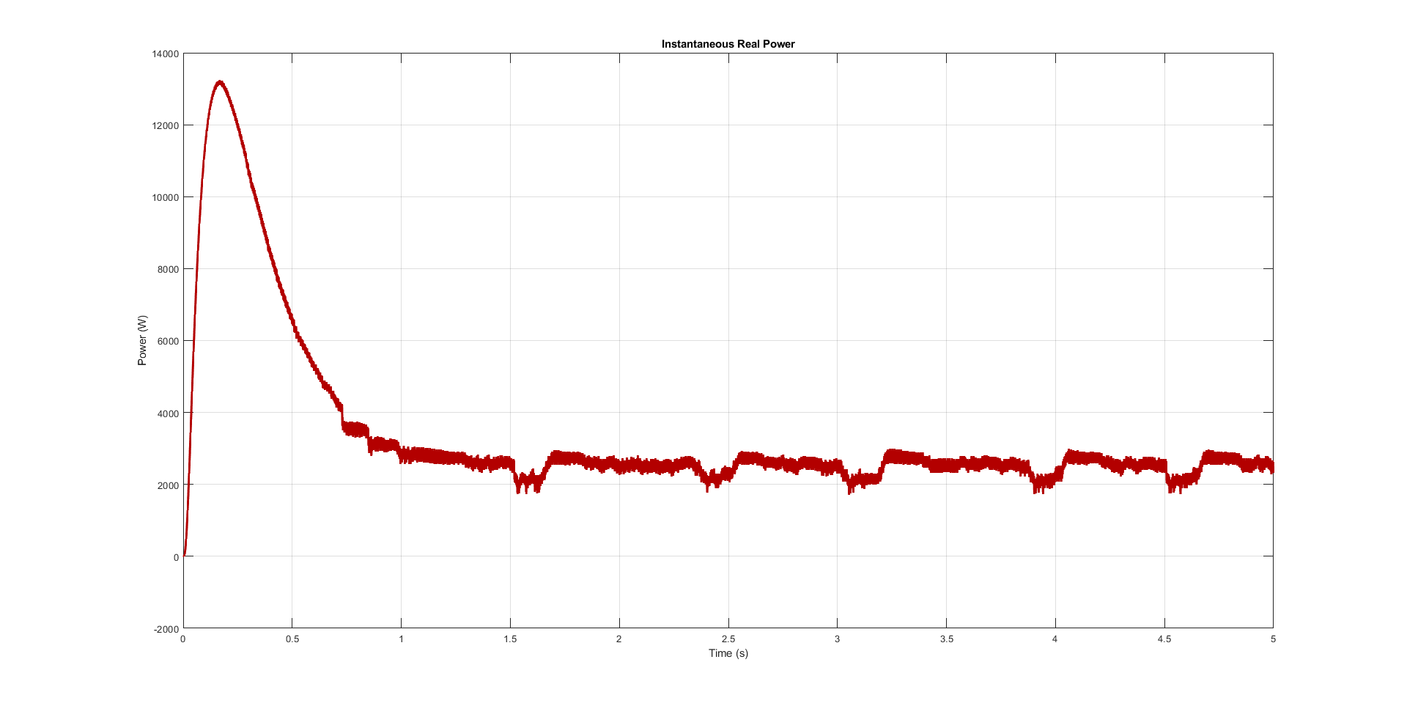
[picture p58: figure]

## Thermal Calculations

For Three-phase rectifier unit

## Thermal Calculations

For the free-wheeling diode

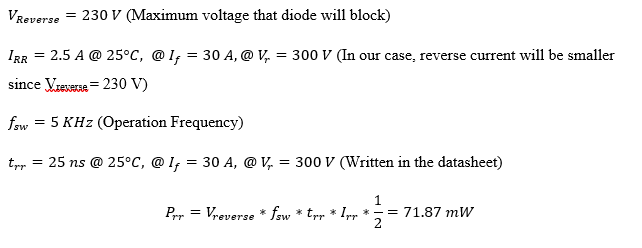
[picture p59: figure]
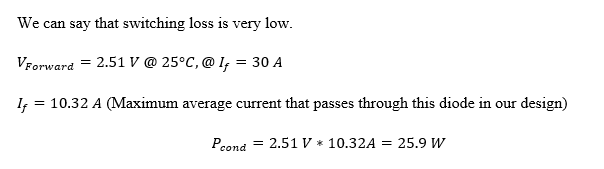
[picture p60: figure]

## Thermal Calculations

For the IGBT

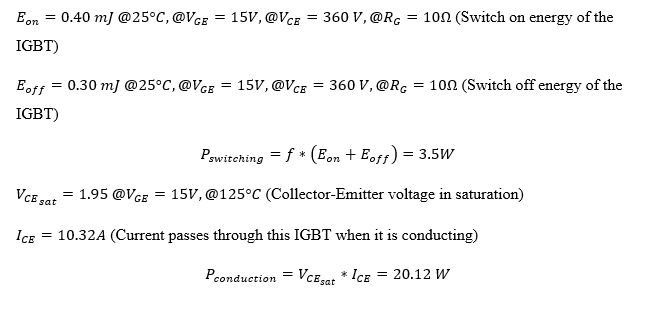
[picture p61: figure]
