sametyakut/EE463-TERM-PROJECT/Box/box_rect_air.dxf

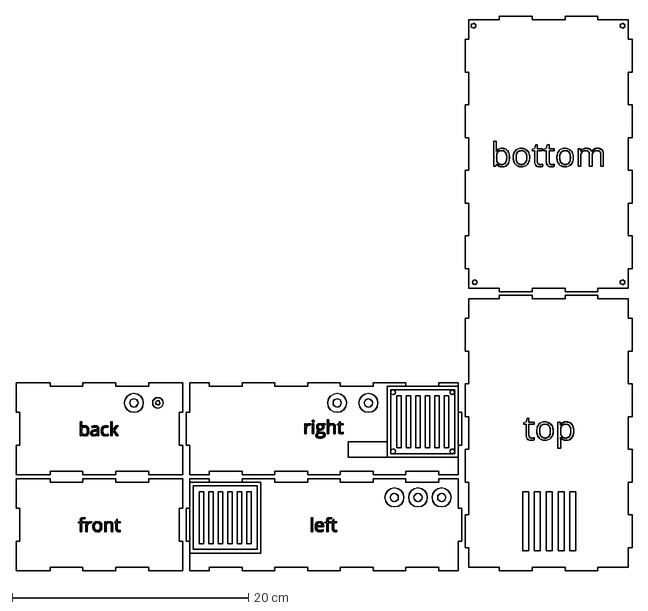
[picture p62: CAD file, 2022-01-19]
Box/box_rect_air.dxf
52.1 x 46.9 cm
