sametyakut/EE463-TERM-PROJECT/Box/box_final.dxf

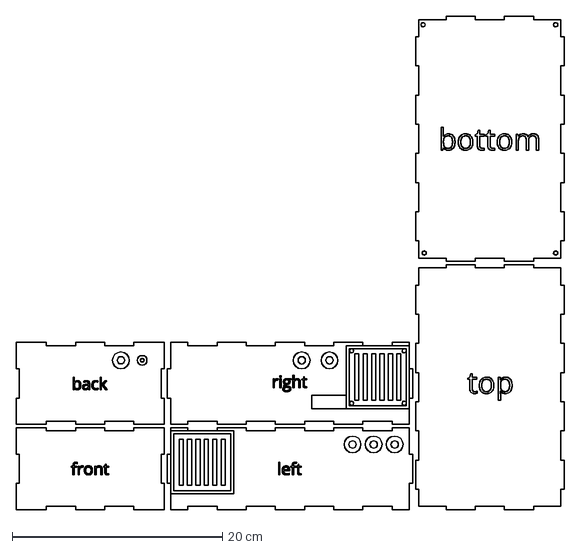
[picture p63: CAD file, 2022-01-18]
Box/box_final.dxf
52.1 x 46.9 cm
