sametyakut/EE463-TERM-PROJECT/Box/box.dxf

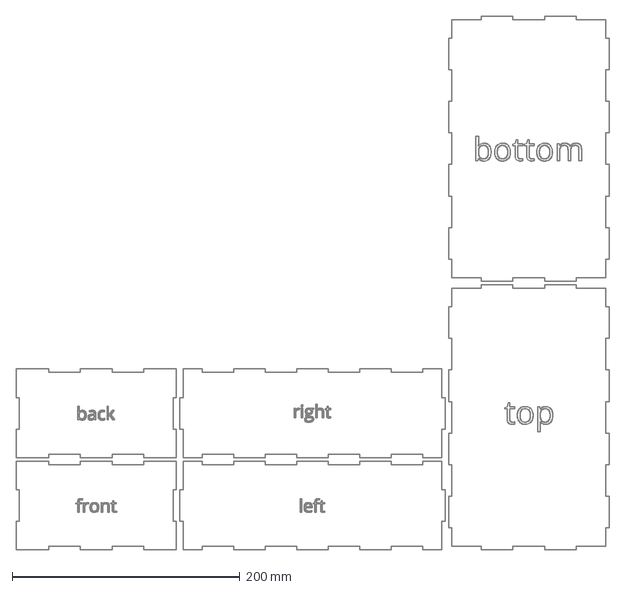
[picture p64: CAD file, 2022-01-18]
Box/box.dxf
521.0 x 469.0 mm
