sametyakut/EE463-TERM-PROJECT/Experiment result Photos/20220117_155326.jpg

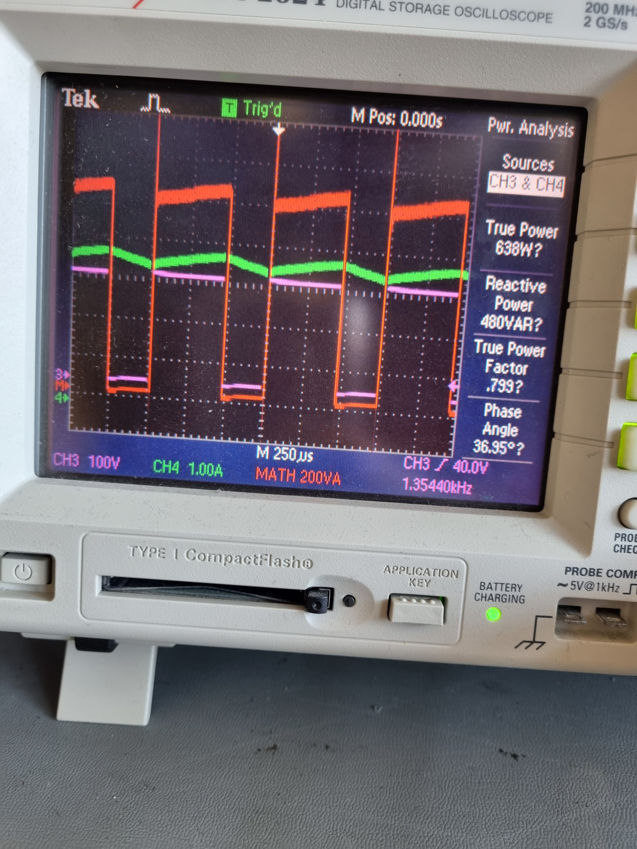
Experiment result Photos/20220117_155326.jpg
