sametyakut/EE463-TERM-PROJECT/Experiment result Photos/20220117_165415.jpg

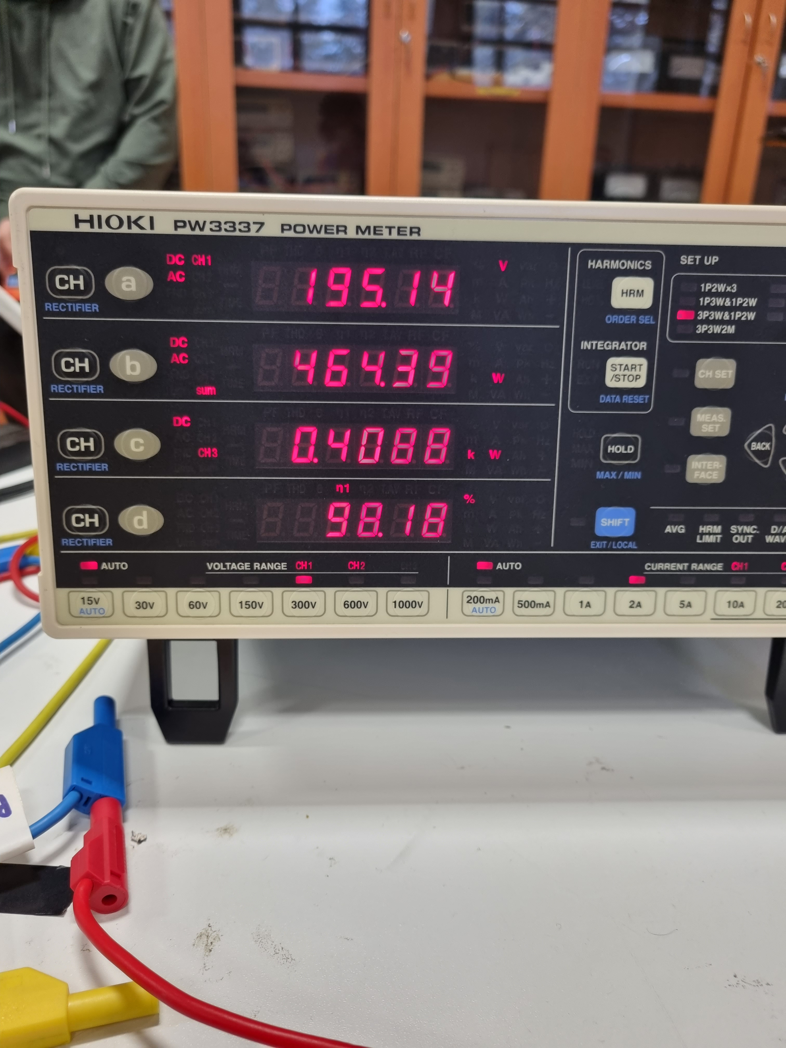
Experiment result Photos/20220117_165415.jpg
