sametyakut/EE463-TERM-PROJECT/Experiment result Photos/20220117_165638.jpg

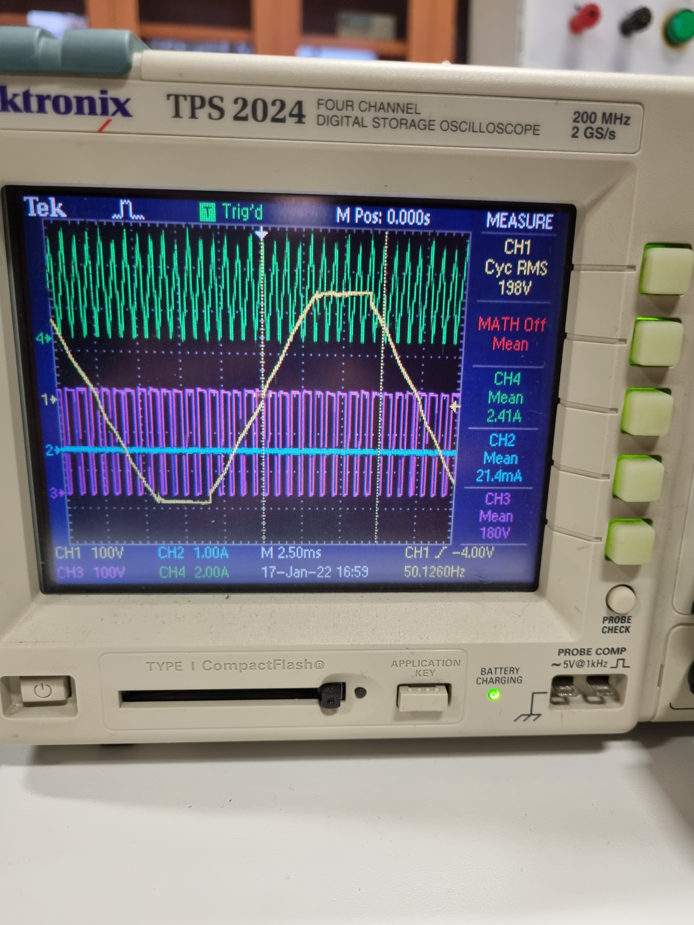
Experiment result Photos/20220117_165638.jpg
