sametyakut/EE463-TERM-PROJECT/Simulation Models/PWM_Generator_555.asc

C1: cap; 100n
C2: cap; 10n
D1: diode
R1: res; 110k
R2: res; 60k
U1: NE555
V1: voltage; 12
Named nets: 0, vdd, Vout
.tran 0.01
