sametyakut/EE463-TERM-PROJECT/Simulation Models/tl494/app_note.asc

C1: cap; 10n
C2: cap; 1n
C3: cap; 2.5µ
D1: diode
L1: ind; 140µ
Q1: npn
Q2: pnp
R1: res; 1k
R2: res; 4k
R3: res; 100
R4: res; 30
R5: res; 270
R6: res; 1Meg
R7: res; 5.1k
R8: res; 5.1k
R9: res; 0.1
R10: res; 50k
R11: res; 9.1k
R12: res; 1k
R13: res; 5.1k
R14: res; 5.1k
R15: res; 510
R16: res; 51k
U1: TL494
V1: voltage; 5
V2: voltage; 32
Named nets: 0, Vref, 2IN-, 1IN+, 2IN+, Vo, DTC, 1IN-, FB
.tran 0 100m 10m 1m uic
