sametyakut/EE463-TERM-PROJECT/Simulation Models/tl494/ytb_pwm_mod.asc

C1: cap; 0.01µ
R1: res; 50k
R2: res; 10k
R3: res; 1k
R4: res; 1k
R5: res; 5k
R6: res; 5k
R7: res; 500k
U1: TL494
V1: voltage; 12
Named nets: 0, Vcc
.tran 0 0.2m 0 10u uic
