sametyakut/EE463-TERM-PROJECT/(commit log)

2021-11-30 PWM Generator Simulation with 555 Timer
2021-12-01 Rectifier and Buck Converter Topology with LC Filter Removed
    Since DC motor has large enough inductor, we may not need any inductor at the output of the buck converter.
2021-12-08 Low-pass filter added
2021-12-22 30A diode datasheet
2022-01-03 Simulation model is converted to the low side switching and transient plots are added to script
2022-01-10 LTSpice model of TL494 and the schematic in the datasheet -simulation too slow
2022-01-18 drawing of the box
    [box.dxf, box_final.dxf]
2022-01-19 box with air channel for rectifier
    [box_rect_air.dxf]
2022-01-24 Update on gate driver
2022-01-25 And, motor turns...
