sametyakut/EE463-TERM-PROJECT/Experiment result Photos/20220117_151822.jpg

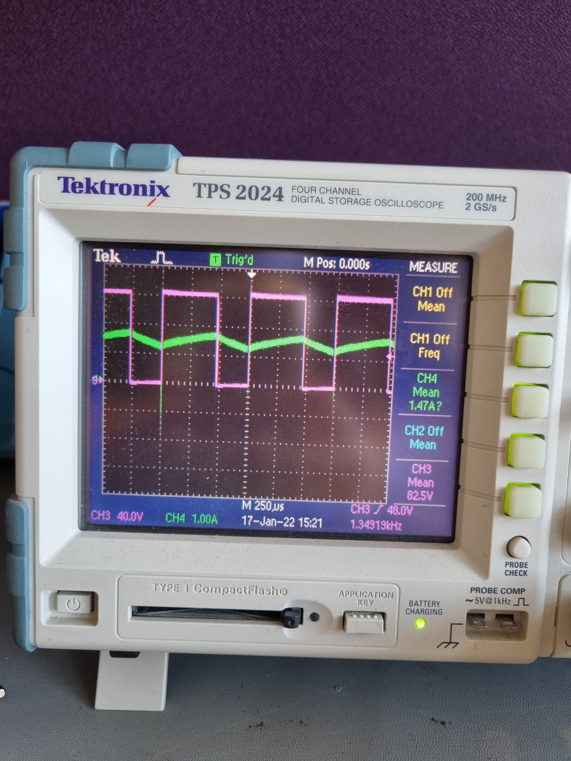
Experiment result Photos/20220117_151822.jpg
