sametyakut/EE463-TERM-PROJECT/Experiment result Photos/20220117_152347.jpg

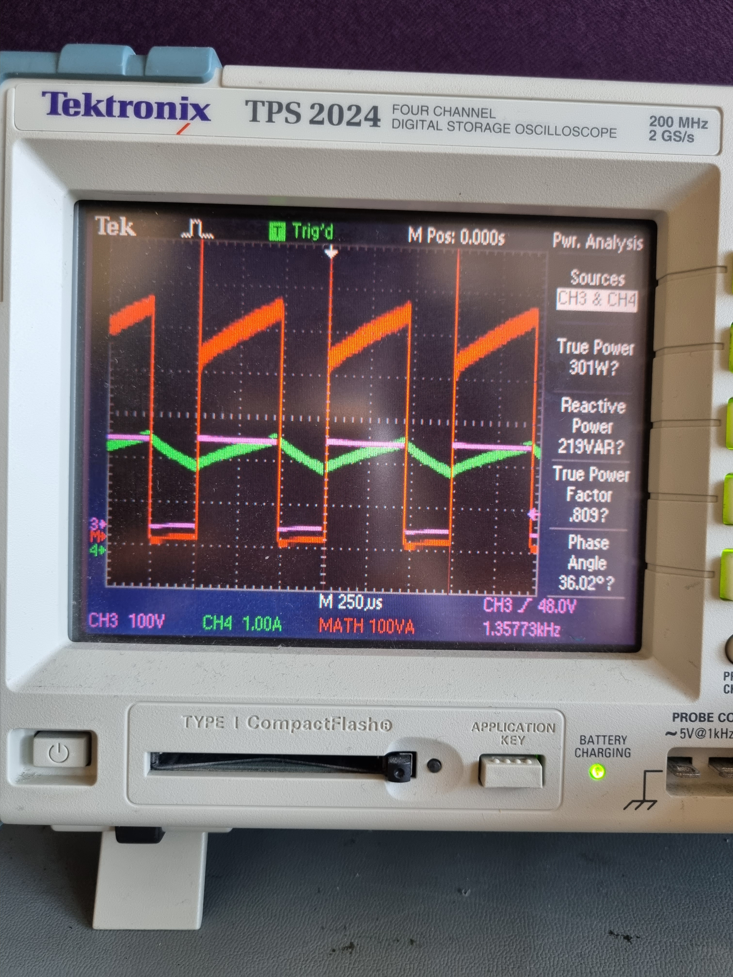
Experiment result Photos/20220117_152347.jpg
