sametyakut/EE463-TERM-PROJECT/Experiment result Photos/20220117_161013.jpg

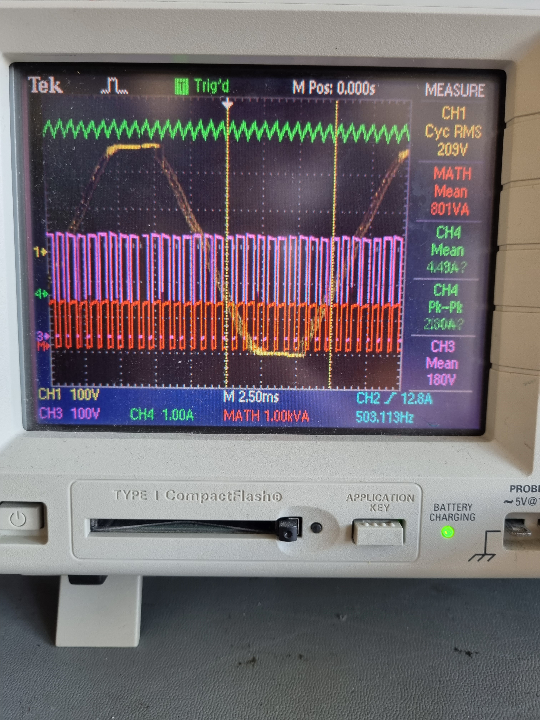
Experiment result Photos/20220117_161013.jpg
